ju8t1n203/Midi-Bass-Guitar/Spring25Docs/Project Prez.odp

## MIDI Bass Guitar

A Project Presented By: Owen Fujii


All images taken by Owen Fujii

## Project Goals

- Develop a MIDI controlled bass guitar
- Bass guitar will closely match the sound of a human player
- Project will have robust firmware to handle a variety of conditions

## Semester Goals

- Develop Firmware for Project
- Develop Schematic/PCB for Project
- Begin planning mechanical platform

## System Breakdown

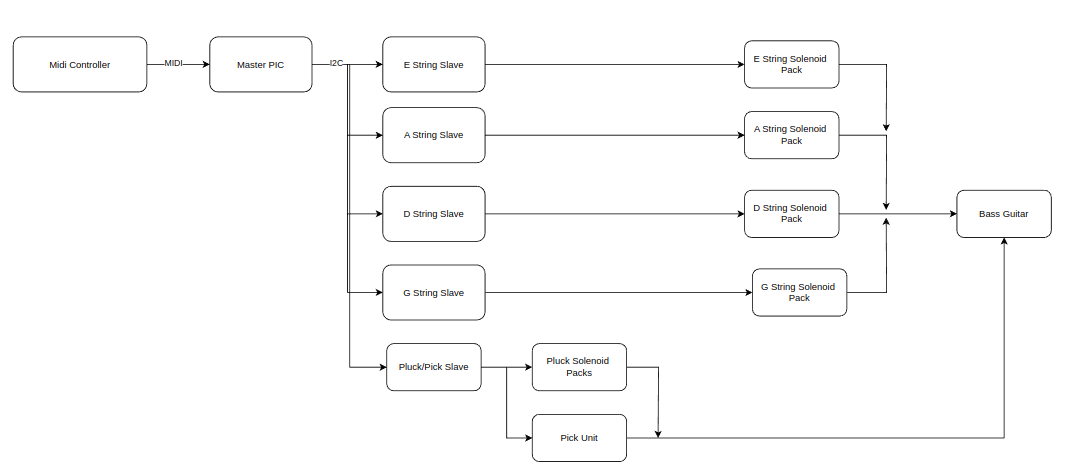
[picture p2: figure]

## Serial Structure

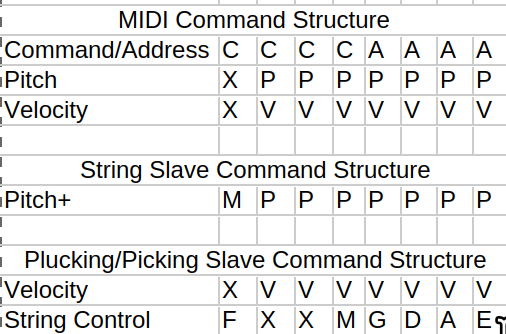
[picture p3: figure]

C = Command

A = Address

P = Pitch

V = Velocity

M = Mute

F = Pick

G = G String

D = D String

A = A String

E = E String

X = Not used

## MIDI

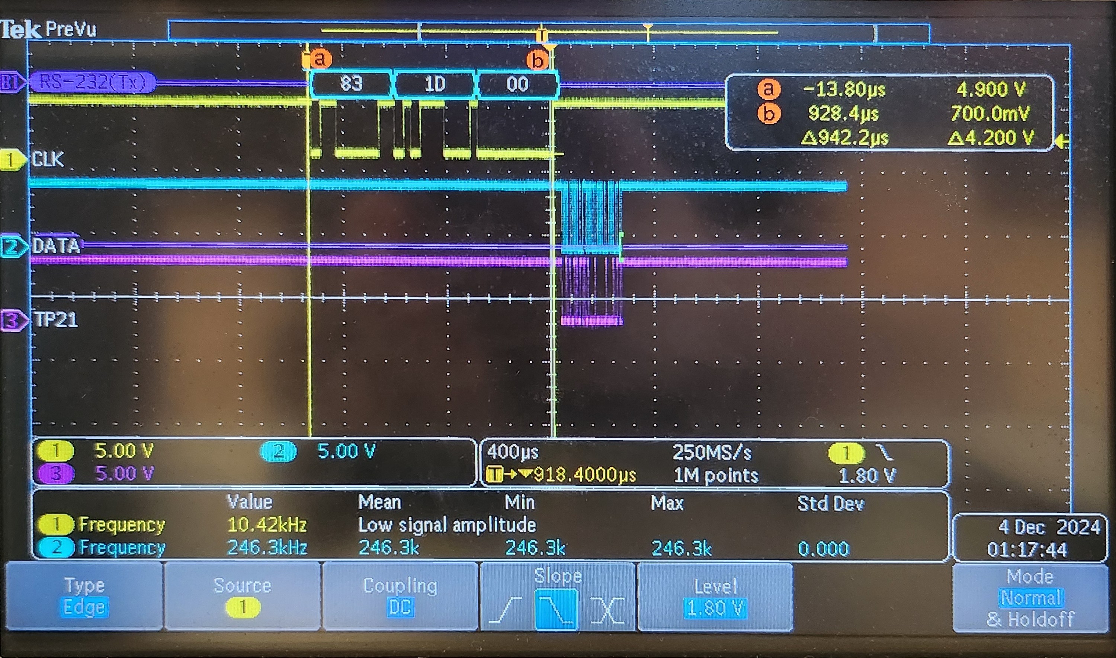
[picture p4: figure]

## I2C

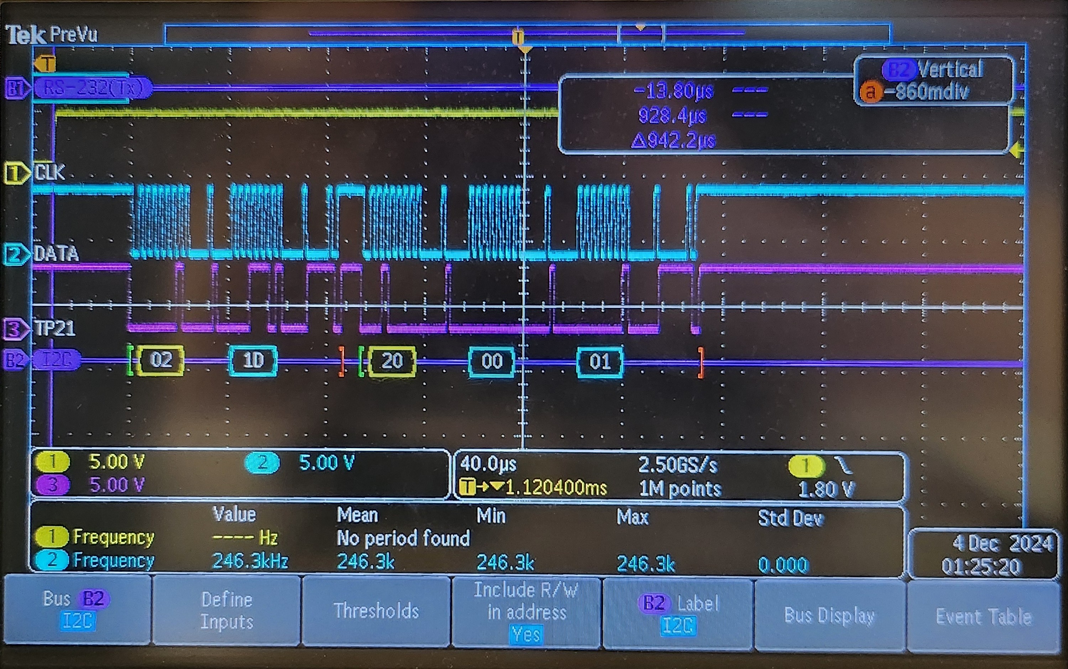
[picture p5: figure]

Notes: Mention why I2C is 400khz

  MIDI = 31.25kHz = 32uS per bit = 320uS per byte transmitted
  I2C = 400kHz = 2.5uS per bit = 25uS per byte transmitted
  120 Beats Per Minute (BPM)
  60s/120bpm = 500ms per beat
  Meaning 1/8th notes are 250ms

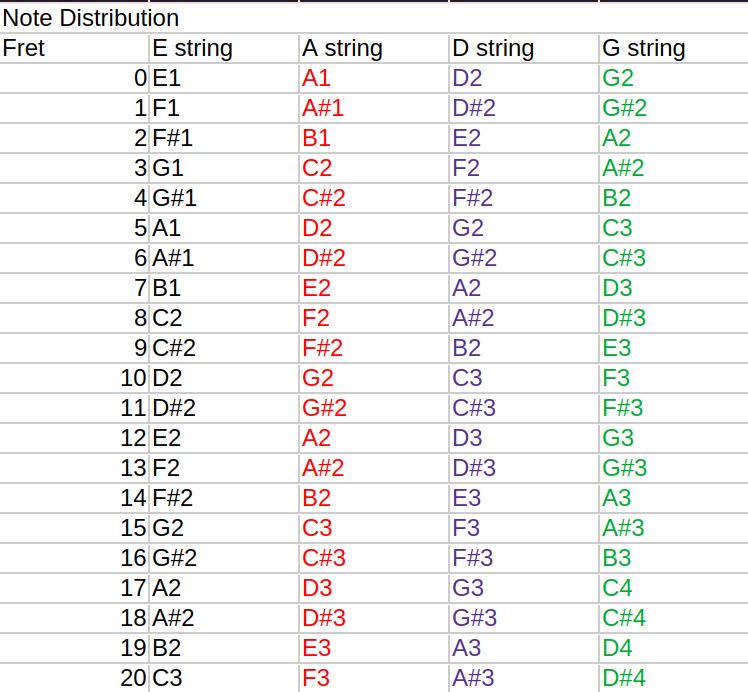
[picture p6: figure]

## String Select

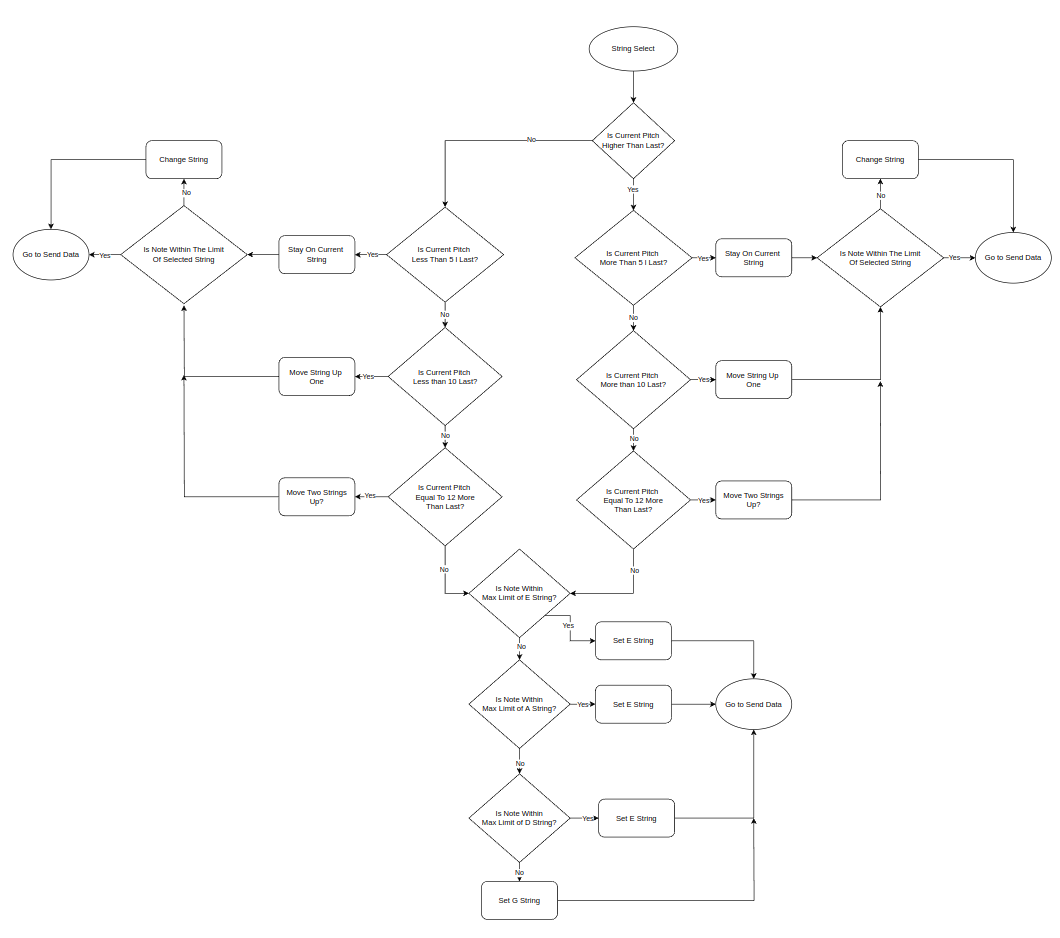
[picture p7: figure]

## External Control

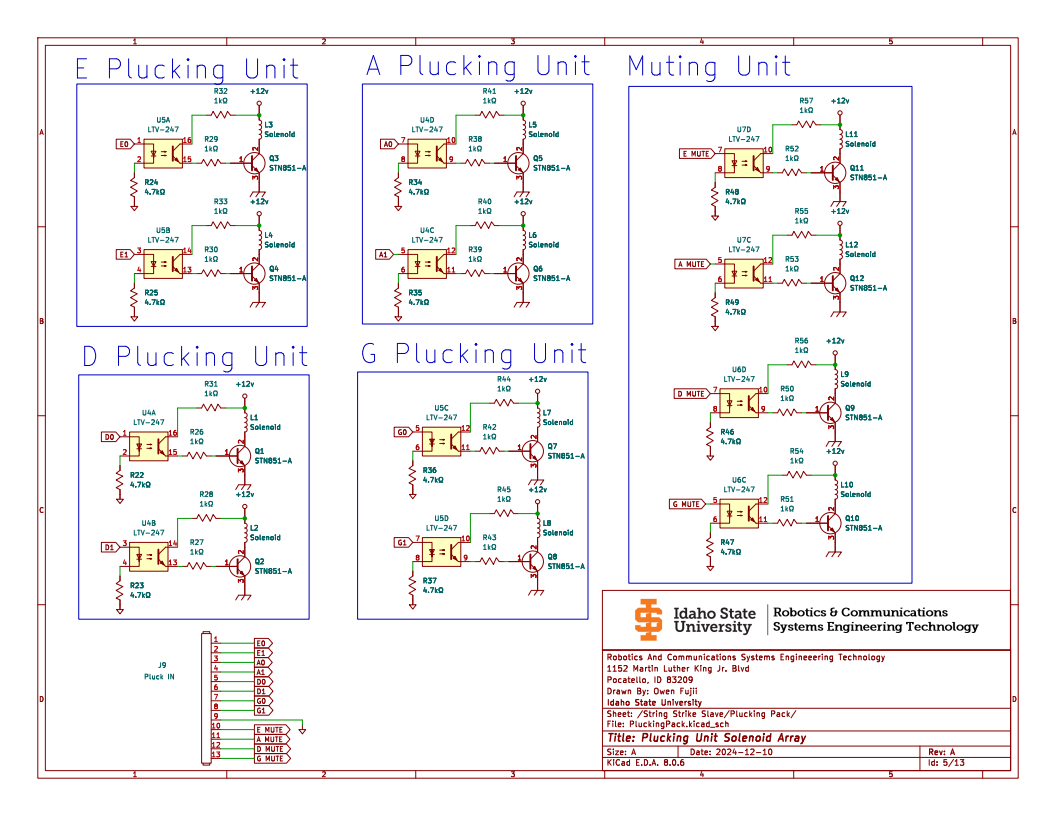
[picture p8: figure]
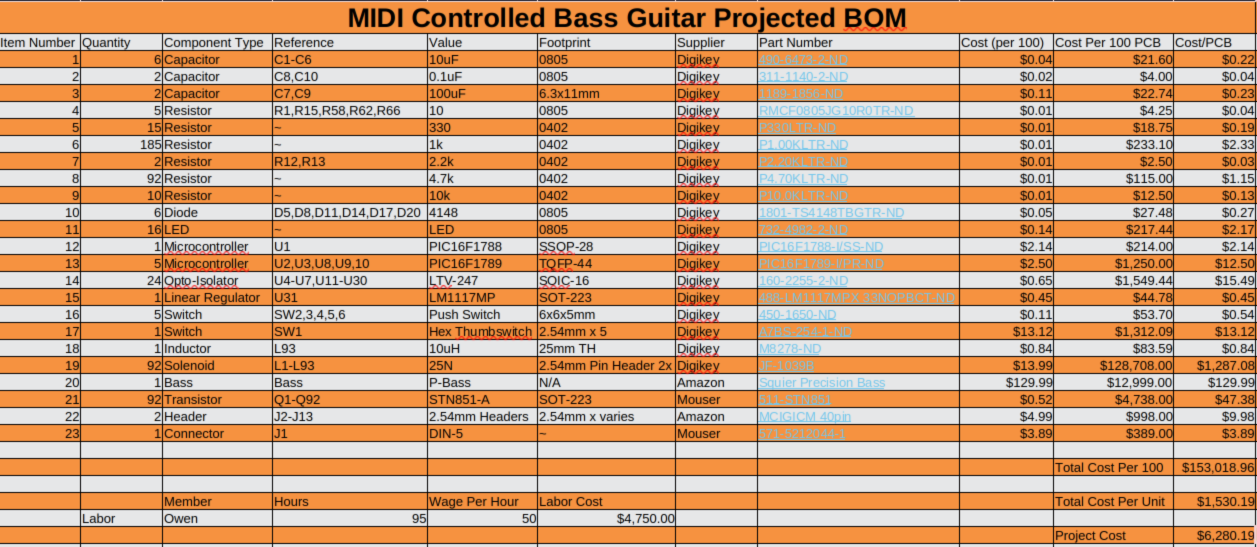
[picture p9: figure]

## Recommendations

- Finish developing string slave firmware
- Design PCB
- Design all mechanical interface hardware

## FIN

  Questions?

Check out the GitHub!!

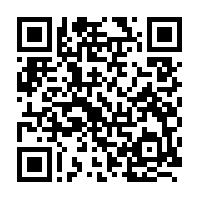
[picture p10: figure]
