ju8t1n203/Midi-Bass-Guitar/Spring25Docs/BOM.ods

MIDI Controlled Bass Guitar Projected BOM
Item Number | Quantity | Component Type | Reference | Value | Footprint | Supplier | Part Number | Cost (per 100) | Cost Per 100 PCB | Cost/PCB
1 | 3 | Capacitor | C1-C3 | 10uF | 0805 | Digikey | 490-6473-2-ND (https://www.digikey.com/en/products/detail/murata-electronics/GRM21BR61C106KE15K/2546903) | $0.04 | $10.80 | $0.11
2 | 2 | Capacitor | C5,C7 | 0.1uF | 0805 | Digikey | 311-1140-2-ND (https://www.digikey.com/en/products/detail/yageo/CC0805KRX7R9BB104/302874) | $0.02 | $4.00 | $0.04
3 | 2 | Capacitor | C4,C6 | 100uF | 6.3x11mm | Digikey | 1189-1856-ND (https://www.digikey.com/en/products/detail/rubycon/16YXF100MEFC6-3X11/3563101) | $0.11 | $22.74 | $0.23
4 | 3 | Resistor | R1,R15,R19 | 10 | 0805 | Digikey | RMCF0805JG10R0TR-ND | $0.01 | $2.55 | $0.03
5 | 9 | Resistor | ~ | 330 | 0402 | Digikey | P330LTR-ND (https://www.digikey.com/en/products/detail/panasonic-electronic-components/ERJ-2RKF3300X/1746189) | $0.01 | $11.25 | $0.11
6 | 21 | Resistor | ~ | 1k | 0402 | Digikey | P1.00KLTR-ND (https://www.digikey.com/en/products/detail/panasonic-electronic-components/ERJ-2RKF1001X/79729) | $0.01 | $26.46 | $0.26
7 | 20 | Power Resistor | ~ | 1K |  | Digikey | RA73F2A10KBTD | $1.06 | $2,120.00 | $21.20
8 | 2 | Resistor | R12,R13 | 2.2k | 0402 | Digikey | P2.20KLTR-ND (https://www.digikey.com/en/products/detail/panasonic-electronic-components/ERJ-2RKF2201X/1746150) | $0.01 | $2.50 | $0.03
9 | 23 | Diode | ~ | 4148 | 0805 | Digikey | 1801-TS4148TBGTR-ND (https://www.digikey.com/en/products/detail/taiwan-semiconductor-corporation/TS4148-RBG/15926409) | $0.05 | $105.34 | $1.05
10 | 30 | LED | ~ | LED | 0805 | Digikey | 732-4982-2-ND (https://www.digikey.com/en/products/detail/würth-elektronik/150080BS75000/4489912) | $0.14 | $407.70 | $4.08
11 | 1 | Microcontroller | U1 | PIC16F1788 | SSOP-28 | Digikey | PIC16F1788-I/SS-ND (https://www.digikey.com/en/products/detail/microchip-technology/PIC16F1788-I-SS/4080108) | $2.14 | $214.00 | $2.14
12 | 2 | Microcontroller | U2,U3,U8,U9,10 | PIC16F1789 | TQFP-44 | Digikey | PIC16F1789-I/PR-ND (https://www.digikey.com/en/products/detail/PIC16F1789-I/PT/PIC16F1789-I/PT-ND/4080209) | $2.50 | $500.00 | $5.00
13 | 5 | Opto-Isolator | U4-U7,U11-U30 | LTV-247 | SOIC-16 | Digikey | 160-2255-2-ND (https://www.digikey.com/en/products/detail/liteon/LTV-247/4307982?s=N4IgTCBcDaIDIBUBqBaMAWA7CAugXyA) | $0.65 | $322.80 | $3.23
14 | 1 | Linear Regulator | U31 | LM1117MP | SOT-223 | Digikey | 488-LM1117MPX 33NOPBCT-ND (https://www.digikey.com/en/products/detail/onsemi/LM1117MPX-33NOPB/13559871) | $0.45 | $44.78 | $0.45
15 | 3 | Switch | SW2-SW4 | Push Switch | 6x6x5mm | Digikey | 450-1650-ND (https://www.digikey.com/en/products/detail/te-connectivity-alcoswitch-switches/1825910-6/1632536) | $0.11 | $32.22 | $0.32
16 | 1 | Switch | SW1 | Hex Thumbswitch | 2.54mm x 5 | Digikey | A7BS-254-1-ND (https://www.digikey.com/en/products/detail/omron-electronics-inc-emc-div/A7BS-254-1/368277) | $13.12 | $1,312.09 | $13.12
17 | 1 | Inductor | L93 | 10uH | 25mm TH | Digikey | M8278-ND (https://www.digikey.com/en/products/detail/bourns-inc/5800-100-RC/774818) | $0.84 | $83.59 | $0.84
18 | 20 | Solenoid | L1-L93 | 25N | 2.54mm Pin Header 2x | Digikey | JF-1039B (https://www.amazon.com/gp/product/B07Z4JQPBN/ref=ppx_yo_dt_b_search_asin_title?ie=UTF8) | $13.99 | $27,980.00 | $279.80
19 | 1 | Bass | Bass | P-Bass | N/A | Amazon | Squier Precision Bass (https://www.amazon.com/Fender-Precision-Beginner-Warranty-Lessons/dp/B0CSLMDCLY/ref=sr_1_5?sr=8-5) | $129.99 | $12,999.00 | $129.99
20 | 10 | Transistor | Q1-Q50 | STN851-A | SOT-223 | Mouser | 511-STN851 (https://www.mouser.com/ProductDetail/STMicroelectronics/STN851?qs=at/PaO0D8JbvrofIPM%2BQzQ%3D%3D) | $0.52 | $515.00 | $5.15
21 | 2 | Header | J2-J13 | 2.54mm Headers | 2.54mm x varies | Amazon | MCIGICM 40pin (https://www.amazon.com/MCIGICM-Header-2-45mm-Arduino-Connector/dp/B07PKKY8BX) | $4.99 | $998.00 | $9.98
22 | 1 | Connector | J1 | DIN-5 | ~ | Mouser | 571-5212044-1 (https://www.mouser.com/ProductDetail/TE-Connectivity/5212044-1?qs=Dic%252B%252BaXKxRiey0gRD2%2Fghg%3D%3D) | $3.89 | $389.00 | $3.89
23 | 1 | PETG | ~ | 1Kg | ~ | Amazon | 1.75mm Matte Grey PETG | $13.99 | $1,399.00 | $13.99
24 | 3 | Aluminuim | ~ | 3m | ~ | Amazon | 1220mm 2020 Aluminuim Extrusion | $35.25 | $10,575.00 | $105.75
25 | 1 | Weather Stripping | ~ | 2ft | ~ | Amazon | Weather Strip Silicone D Shaped | $0.99 | $99.00 | $0.99
 |  |  |  |  |  |  |  |  | Total Cost Per 100 | $60,176.82
 |  | Member | Hours | Wage Per Hour | Labor Cost
 |  |  |  |  |  |  |  |  | Total Cost Per Unit | $601.77
 | Labor | Owen | 95 | 50 | $4,750.00
 |  | Justin | 96 | 50 | $4,800.00 |  |  |  | Project Cost | $10,151.77
