ju8t1n203/Midi-Bass-Guitar/JustinHours.xlsx

Sheet: W1
Justin Week One Hours
Date | Clock-In | Clock-Out | Time(hrs) | Description
2025-04-07 | 10:00:00 | 11:00:00 | 1 | breadboarding
2025-04-07 | 13:15:00 | 14:30:00 | 1.25 | git branch organization
2025-04-08 | 13:00:00 | 14:30:00 | 1.5 | finished breadboarding
2025-04-09 | 10:00:00 | 12:00:00 | 2 | figuring out midi
2025-04-09 | 13:15:00 | 15:00:00 | 1.75 | I2C troubleshooting
2025-04-10 | 10:00:00 | 11:00:00 | 1 | I2C troubleshooting
2025-04-10 | 13:15:00 | 14:30:00 | 1.25 | I2C troubleshooting
2025-04-11 | 13:00:00 | 14:30:00 | 1.5 | I2C troubleshooting
2025-04-11 | 10:00:00 | 12:00:00 | 2 | I2C troubleshooting
2025-04-12 | 13:15:00 | 15:00:00 | 1.75 | I2C troubleshooting
2025-04-12 | 10:00:00 | 11:00:00 | 1 | I2C troubleshooting
2025-04-13 | 13:15:00 | 14:30:00 | 1.25 | I2C troubleshooting
2025-04-13 | 13:00:00 | 14:30:00 | 1.5 | I2C troubleshooting
 |  | Total: | 18.75

Sheet: W2
Justin Week Two Hours
Date | Clock-In | Clock-Out | Time(hrs) | Description
2025-04-14 | 9:00:00 | 11:40:00 | 2.667 | I2C troubleshooting
2025-04-14 | 12:40:00 | 14:30:00 | 1.833 | I2C troubleshooting
2025-04-15 | 9:00:00 | 11:45:00 | 2.75 | I2C troubleshooting
2025-04-15 | 13:15:00 | 14:40:00 | 1.417 | I2C troubleshooting
2025-04-16 | 9:00:00 | 11:40:00 | 2.667 | Finalizing Fret Slave
2025-04-16 | 13:00:00 | 16:00:00 | 3 | Finalizing Fret Slave
2025-04-17 | 9:15:00 | 11:40:00 | 2.417 | Investigationg MIDI over IR
2025-04-17 | 13:00:00 | 15:30:00 | 2.5 | Investigationg MIDI over IR
2025-04-18 | 9:00:00 | 11:40:00 | 2.667 | Investigationg MIDI over IR
2025-04-18 | 13:00:00 | 15:00:00 | 2 | Investigationg MIDI over IR
 |  | Total: | 23.917

Sheet: W3
Justin Week Three Hours
Date | Clock-In | Clock-Out | Time(hrs) | Description
2025-04-21 | 9:00:00 | 11:40:00 | 2.667 | Investigationg MIDI over IR
2025-04-21 | 12:40:00 | 14:30:00 | 1.833 | Investigationg MIDI over IR
2025-04-22 | 9:00:00 | 11:45:00 | 2.75 | Investigationg MIDI over IR
2025-04-22 | 13:15:00 | 14:40:00 | 1.417 | Investigationg MIDI over IR
2025-04-23 | 9:00:00 | 11:40:00 | 2.667 | Investigationg MIDI over IR
2025-04-23 | 13:00:00 | 16:00:00 | 3 | Investigationg MIDI over IR
2025-04-24 | 9:15:00 | 11:40:00 | 2.417 | Investigationg MIDI over IR
2025-04-24 | 13:00:00 | 15:30:00 | 2.5 | Investigationg MIDI over IR
2025-04-25 | 9:00:00 | 11:40:00 | 2.667 | Investigationg MIDI over IR
2025-04-25 | 13:00:00 | 15:00:00 | 2 | Investigationg MIDI over IR
 |  | Total: | 23.917

Sheet: W4
Justin Week Four Hours
Date | Clock-In | Clock-Out | Time(hrs) | Description
2025-04-28 | 9:30:00 | 11:40:00 | 2.167 | Investigationg MIDI over IR
2025-04-28 | 13:00:00 | 14:40:00 | 1.667 | Investigationg MIDI over IR
2025-04-29 | 9:00:00 | 11:40:00 | 2.667 | Investigationg MIDI over IR
2025-04-29 | 12:45:00 | 14:40:00 | 1.917 | Investigationg MIDI over IR
2025-04-30 | 9:15:00 | 11:40:00 | 2.417 | Investigationg MIDI over IR
2025-04-30 | 12:30:00 | 16:00:00 | 3.5 | Write up for MIDI over IR
2025-05-01 | 9:15:00 | 11:20:00 | 2.083 | Write up for MIDI over IR
2025-05-01 | 13:00:00 | 15:00:00 | 2 | Write up for fret slave
2025-05-02 | 9:10:00 | 11:40:00 | 2.5 | Write up for MIDI over IR
2025-05-02 | 13:00:00 | 15:00:00 | 2 | Write up for fret slave
 |  | Total: | 22.917

Sheet: W5
Justin Week Five Hours
Date | Clock-In | Clock-Out | Time(hrs) | Description
2025-05-05 | 9:30:00 | 11:40:00 | 2.167 | Write up for MIDI over IR
2025-05-05 | 13:00:00 | 14:40:00 | 1.667 | Soldering Amplifier Board
2025-05-06 | 9:00:00 | 11:40:00 | 2.667 | Writing Presentation
2025-05-06 |  |  | 0.000
2025-05-07 |  |  | 0.000
2025-05-07 |  |  | 0
2025-05-08 |  |  | 0.000
2025-05-08 |  |  | 0
 |  | Total: | 6.500

Sheet: Sem6
Week# | Date | In | Out | Time | Description
1 | 2025-10-20 | 11:00:00 | 12:00:00 | 1 | IR Tx Board Design
1 | 2025-10-20 | 12:30:00 | 14:50:00 | 2.333 | IR Tx Board Design | Part | Link
1 | 2025-10-21 | 11:00:00 | 11:33:00 | 0.550 | IR Tx Board Design | 2Ω Power Resistor | https://www.mouser.com/ProductDetail/Bourns/PWR220T-20-2R00F?qs=sGAEpiMZZMtlubZbdhIBIIFas8kKGM5fidmq4iLVFG8%3D
1 | 2025-10-21 | 13:00:00 | 16:30:00 | 3.500 | IR Tx Board Design
1 | 2025-10-22 | 11:00:00 | 12:00:00 | 1.000 | IR Rx Circuit Design | 8Pin Molex | 430450810
1 | 2025-10-22 | 13:00:00 | 14:50:00 | 1.833 | IR Rx Circuit Design | 2Pin Molex | 430450200
1 | 2025-10-23 | 13:00:00 | 15:00:00 | 2.000 | IR Tx Board Design
1 | 2025-10-24 | 10:00:00 | 12:00:00 | 2.000 | IR Tx Board Design
2 | 2025-10-27 | 11:00:00 | 12:00:00 | 1.000 | IR Rx Circuit Design
2 | 2025-10-27 | 13:00:00 | 14:30:00 | 1.500 | IR Rx Circuit Design
2 | 2025-10-28 | 10:30:00 | 12:00:00 | 1.500 | IR Rx Circuit Design
2 | 2025-10-28 | 12:30:00 | 14:30:00 | 2.000 | IR Rx Circuit Design
2 | 2025-10-29 | 13:00:00 | 15:00:00 | 2.000 | IR Tx Board Design
2 | 2025-10-29 | 10:00:00 | 12:00:00 | 2.000 | IR Tx Board Design
2 | 2025-10-30 | 11:00:00 | 12:00:00 | 1.000 | IR Rx Circuit Design
2 | 2025-10-30 | 13:00:00 | 14:30:00 | 1.500 | IR Rx Circuit Design
2 | 2025-10-31 | 10:30:00 | 12:00:00 | 1.500 | IR Rx Circuit Design
2 | 2025-10-31 | 12:30:00 | 14:30:00 | 2.000 | IR Rx Circuit Design
3 | 2025-11-03 | 11:00:00 | 12:00:00 | 1.000 | IR Tx Board Design
3 | 2025-11-03 | 12:50:00 | 15:10:00 | 2.333 | IR Tx Board Design
3 | 2025-11-04 | 11:00:00 | 12:05:00 | 1.083 | IR Tx Board Design
3 | 2025-11-04 | 13:00:00 | 14:35:00 | 1.583 | IR Tx Board Design
3 | 2025-11-05 | 9:00:00 | 9:40:00 | 0.667 | IR Rx Circuit Design
3 | 2025-11-05 | 9:40:00 | 12:00:00 | 2.333 | Bass Fret Bar Design
3 | 2025-11-05 | 13:00:00 | 16:00:00 | 3.000 | Equipment Maintenance
3 | 2025-11-06 | 13:30:00 | 15:30:00 | 2.000 | Equipment Maintenance
3 | 2025-11-07 | 9:00:00 | 12:00:00 | 3.000 | Equipment Maintenance
3 | 2025-11-07 | 13:00:00 | 15:00:00 | 2.000 | Equipment Maintenance
4 | 2025-11-10 | 11:00:00 | 12:00:00 | 1.000 | Equipment Maintenance
4 | 2025-11-10 | 13:00:00 | 15:00:00 | 2.000 | Administration
4 | 2025-11-11 | 11:00:00 | 12:00:00 | 1.000 | CAD work
4 | 2025-11-11 | 13:00:00 | 15:00:00 | 2.000 | Designing SUDO code
4 | 2025-11-12 | 11:06:00 | 12:15:00 | 1.150 | CAD work
4 | 2025-11-12 | 13:00:00 | 14:50:00 | 1.833 | Universal Master circuit design
4 | 2025-11-13 | 10:50:00 | 11:30:00 | 0.667 | Universal Master circuit design
4 | 2025-11-13 | 11:30:00 | 12:00:00 | 0.500 | Fret circuit design
4 | 2025-11-13 | 13:00:00 | 13:30:00 | 0.500 | Universal Master circuit design
4 | 2025-11-13 | 13:30:00 | 14:30:00 | 1.000 | Fret circuit design
4 | 2025-11-13 | 14:30:00 | 15:00:00 | 0.500 | Pluck circuit design
4 | 2025-11-14 | 9:00:00 | 12:30:00 | 3.500 | Universal Master PCB design
4 | 2025-11-14 | 13:00:00 | 14:30:00 | 1.500 | Universal Master PCB design
4 | 2025-11-15 | 11:00:00 | 14:00:00 | 3.000 | Universal Slave PCB design
