ju8t1n203/Midi-Bass-Guitar/Bass Guitar Cad Models/F25/Fret/GenrealBar.stl

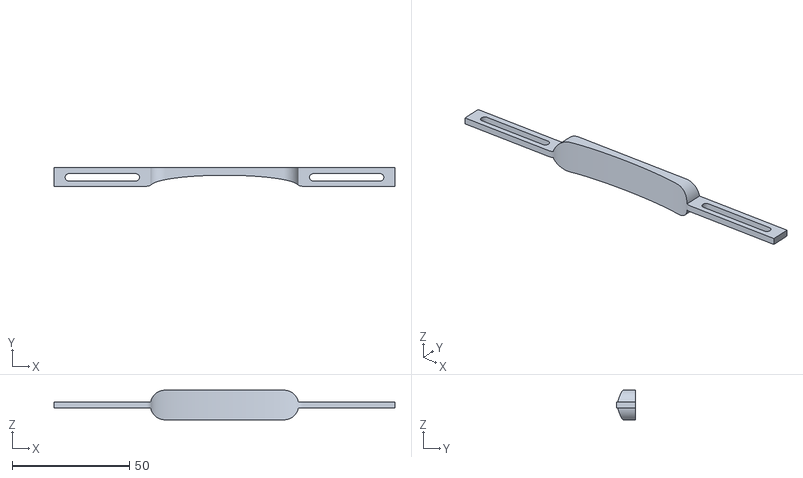
[picture p60: CAD file, 2025-11-12]
Bass Guitar Cad Models/F25/Fret/GenrealBar.stl
145.7 x 7.92 x 12.7
