ju8t1n203/Midi-Bass-Guitar/Bass Guitar Cad Models/S25/4n Solenoid Pin.SLDPRT

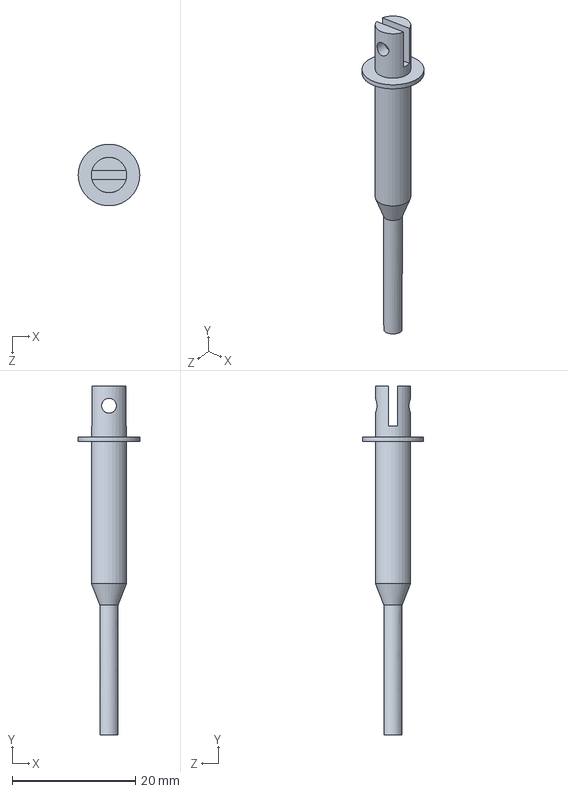
[picture p61: CAD file, 2025-11-05]
Bass Guitar Cad Models/S25/4n Solenoid Pin.SLDPRT
10.0 x 56.6 x 9.97 mm
