ju8t1n203/Midi-Bass-Guitar/Bass Guitar Cad Models/S25/Electronics/DIN Mounting Rail.SLDPRT

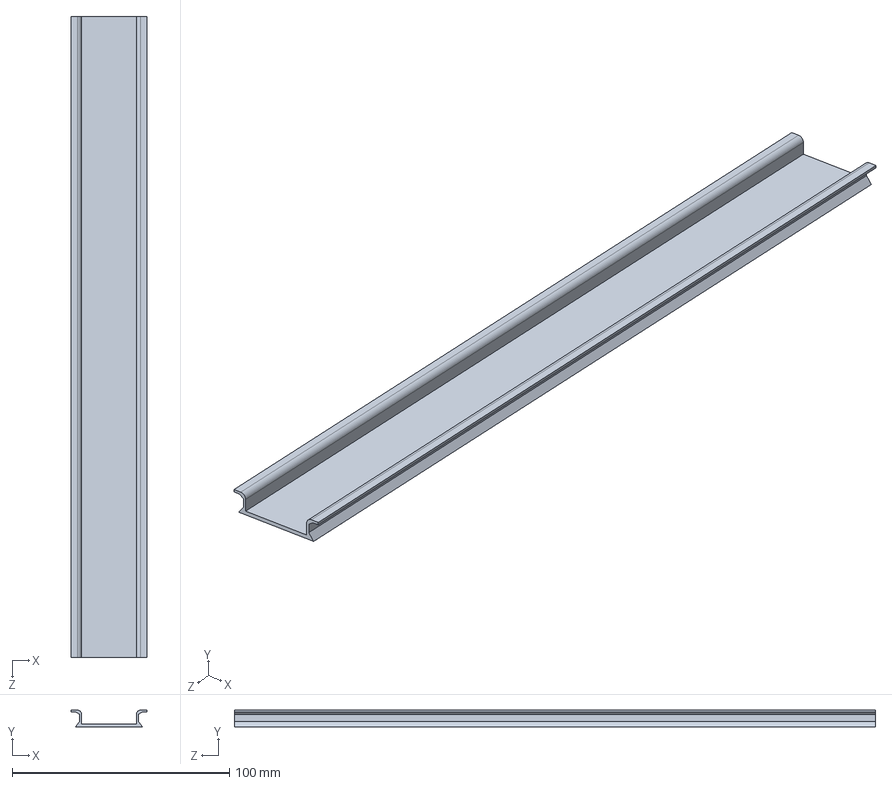
[picture p62: CAD file, 2025-11-05]
Bass Guitar Cad Models/S25/Electronics/DIN Mounting Rail.SLDPRT
34.8 x 7.82 x 295.0 mm
