ju8t1n203/Midi-Bass-Guitar/Bass Guitar Cad Models/S25/Fret Bars/2nd Fret Bar.SLDPRT

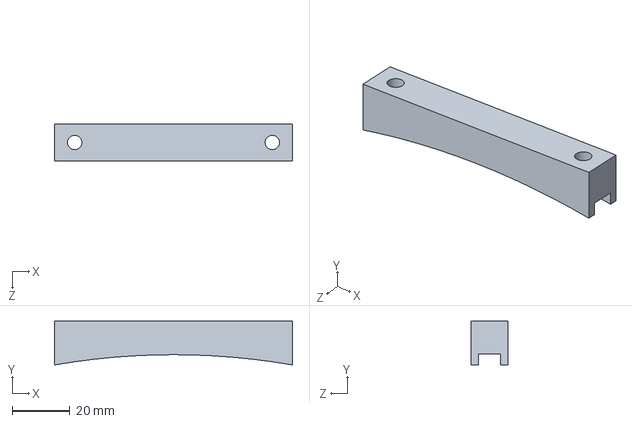
[picture p63: CAD file, 2025-11-05]
Bass Guitar Cad Models/S25/Fret Bars/2nd Fret Bar.SLDPRT
82.6 x 15.2 x 12.7 mm
