ju8t1n203/Midi-Bass-Guitar/Bass Guitar Cad Models/S25/STLs/5th Fret Bar.STL

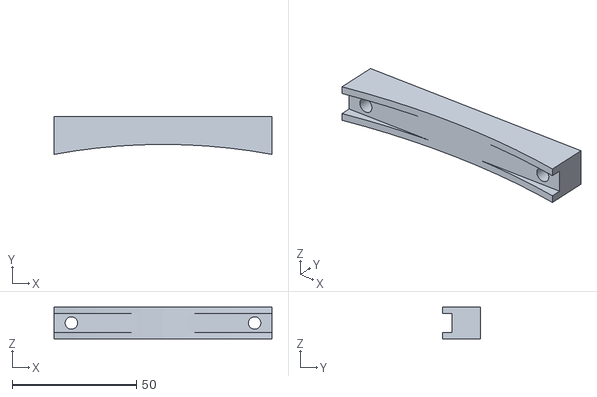
[picture p64: CAD file, 2025-11-05]
Bass Guitar Cad Models/S25/STLs/5th Fret Bar.STL
87.8 x 15.2 x 12.7
