ju8t1n203/Midi-Bass-Guitar/Bass Guitar Cad Models/F25/Fret/SolenoidMount.stl

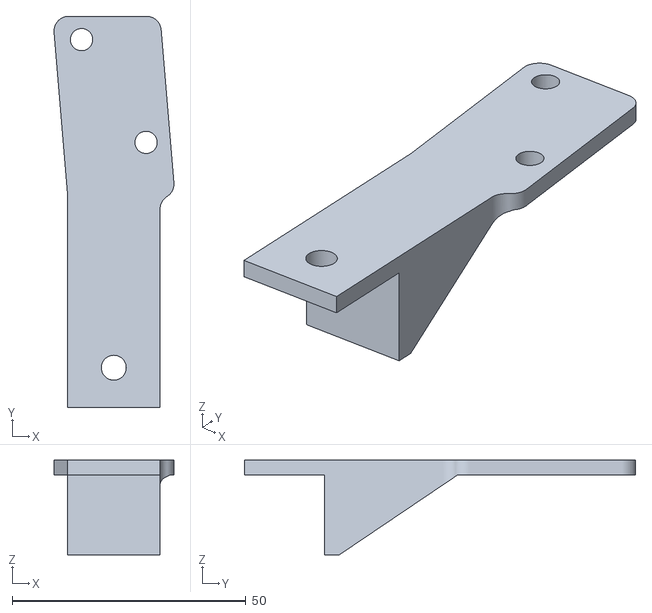
[picture p65: CAD file, 2025-11-11]
Bass Guitar Cad Models/F25/Fret/SolenoidMount.stl
25.7 x 83.8 x 20.3
