ju8t1n203/Midi-Bass-Guitar/Bass Guitar Cad Models/S25/Electronics/2.54mm Header Single.SLDPRT

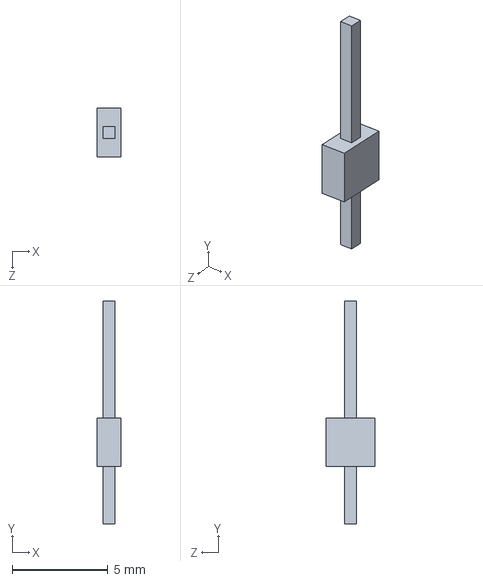
[picture p66: CAD file, 2025-11-05]
Bass Guitar Cad Models/S25/Electronics/2.54mm Header Single.SLDPRT
1.27 x 11.6 x 2.54 mm
