ju8t1n203/Midi-Bass-Guitar/Bass Guitar Cad Models/S25/Fret Bars/14th Fret Bar.SLDPRT

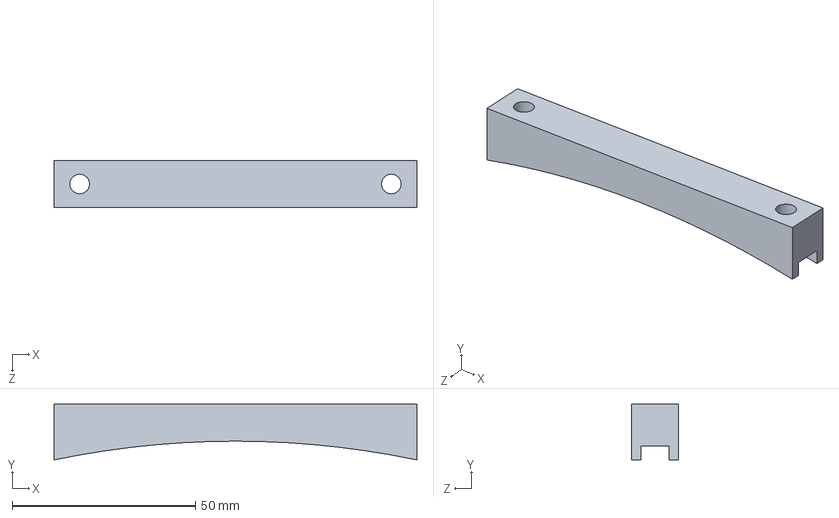
[picture p67: CAD file, 2025-11-05]
Bass Guitar Cad Models/S25/Fret Bars/14th Fret Bar.SLDPRT
98.9 x 15.2 x 12.7 mm
