ju8t1n203/Midi-Bass-Guitar/Bass Guitar Cad Models/S25/Small Mounting Bracket.SLDPRT

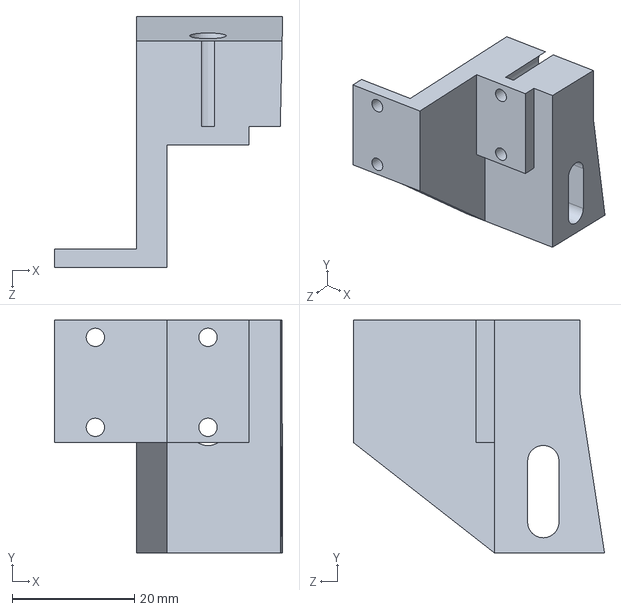
[picture p68: CAD file, 2025-11-05]
Bass Guitar Cad Models/S25/Small Mounting Bracket.SLDPRT
37.3 x 38.0 x 41.0 mm
