ju8t1n203/Midi-Bass-Guitar/Bass Guitar Cad Models/S25/STLs/20th Fret Bar.STL

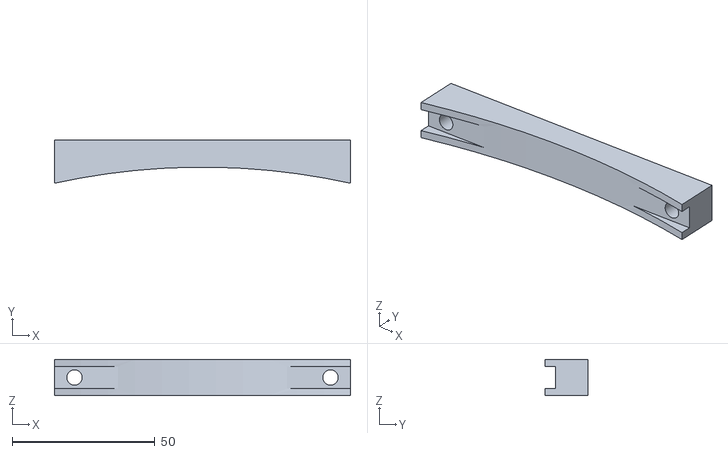
[picture p69: CAD file, 2025-11-05]
Bass Guitar Cad Models/S25/STLs/20th Fret Bar.STL
103.7 x 15.2 x 12.7
