ju8t1n203/Midi-Bass-Guitar/Bass Guitar Cad Models/S25/Electronics/2.54mm Header 21-pin.SLDPRT

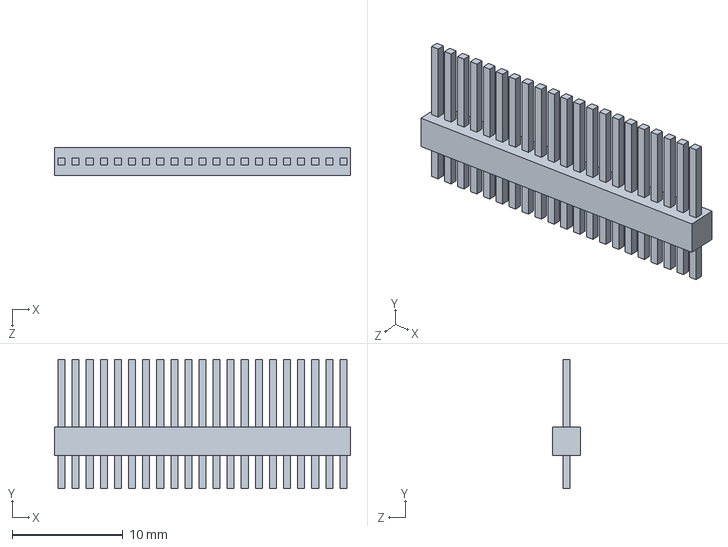
[picture p70: CAD file, 2025-11-05]
Bass Guitar Cad Models/S25/Electronics/2.54mm Header 21-pin.SLDPRT
26.7 x 11.6 x 2.54 mm
