ju8t1n203/Midi-Bass-Guitar/Bass Guitar Cad Models/S25/Fret Bars/5th Fret Bar.SLDPRT

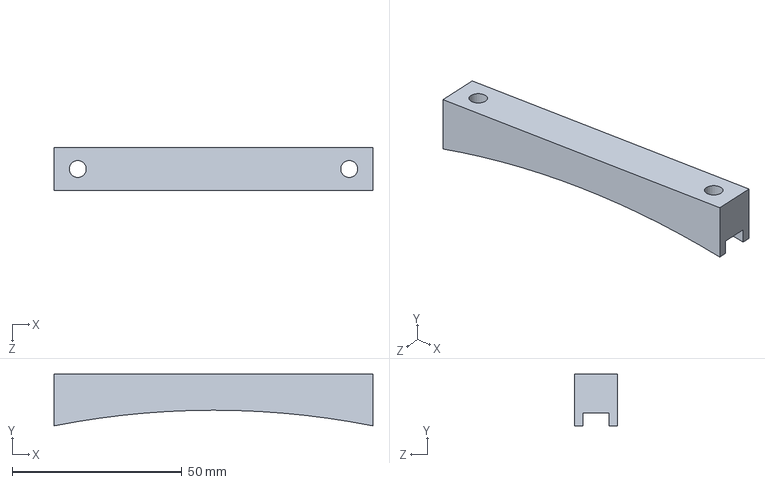
[picture p71: CAD file, 2025-11-05]
Bass Guitar Cad Models/S25/Fret Bars/5th Fret Bar.SLDPRT
93.9 x 15.2 x 12.7 mm
