ju8t1n203/Midi-Bass-Guitar/Bass Guitar Cad Models/S25/P-Bass Body.SLDPRT

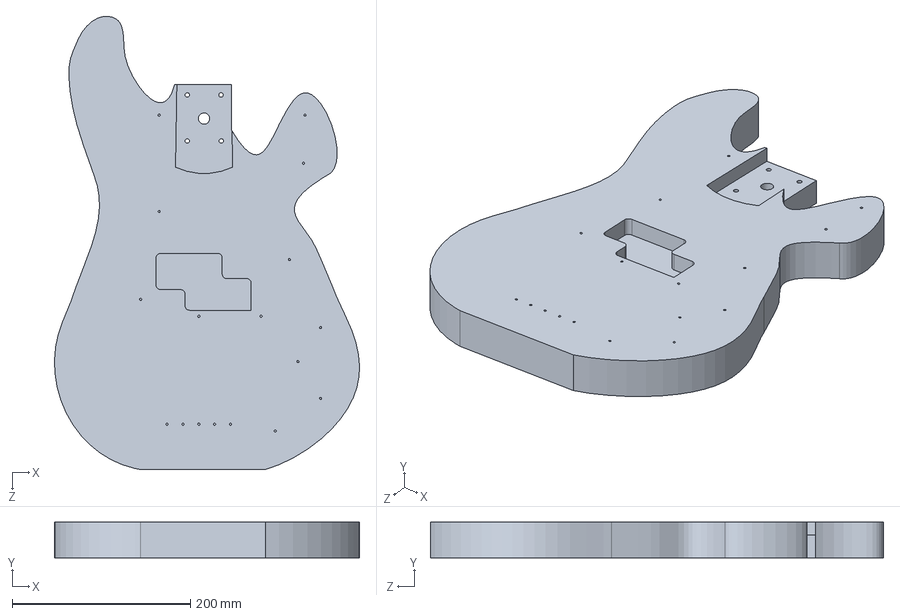
[picture p72: CAD file, 2025-11-05]
Bass Guitar Cad Models/S25/P-Bass Body.SLDPRT
341.8 x 40.0 x 507.9 mm
