ju8t1n203/Midi-Bass-Guitar/Bass Guitar Cad Models/S25/Electronics/Solenoid Hori Mount.SLDPRT

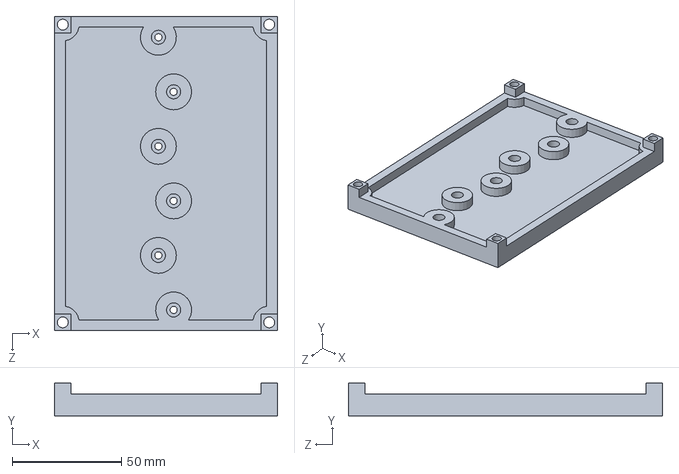
[picture p74: CAD file, 2025-11-05]
Bass Guitar Cad Models/S25/Electronics/Solenoid Hori Mount.SLDPRT
102.2 x 15.0 x 144.1 mm
