ju8t1n203/Midi-Bass-Guitar/Bass Guitar Cad Models/S25/Fret Bars/Sponge Blank.SLDPRT

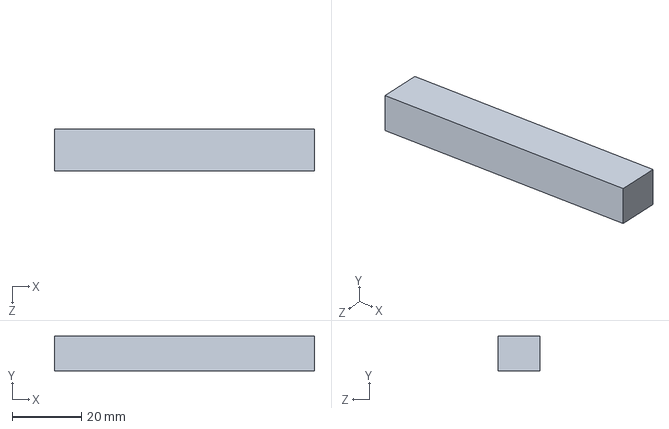
[picture p75: CAD file, 2025-11-05]
Bass Guitar Cad Models/S25/Fret Bars/Sponge Blank.SLDPRT
74.8 x 10.0 x 12.0 mm
