ju8t1n203/Midi-Bass-Guitar/Bass Guitar Cad Models/S25/Top Cross Support.SLDPRT

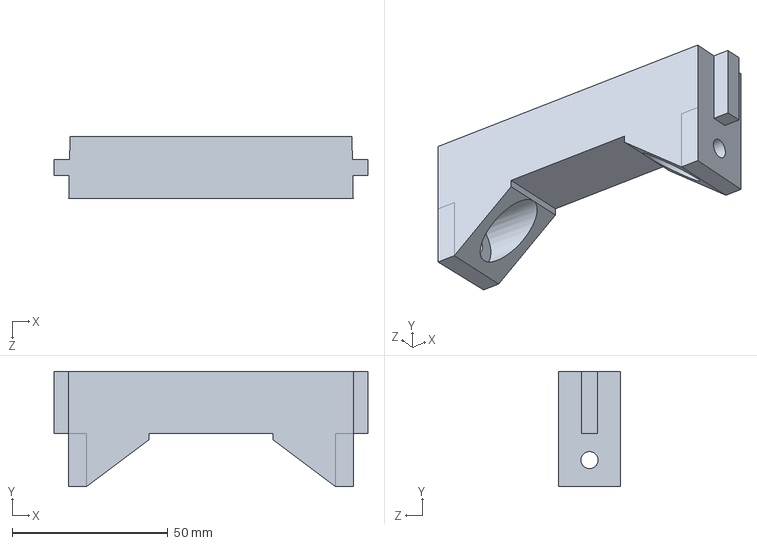
[picture p77: CAD file, 2025-11-05]
Bass Guitar Cad Models/S25/Top Cross Support.SLDPRT
100.9 x 37.0 x 20.0 mm
