ju8t1n203/Midi-Bass-Guitar/Bass Guitar Cad Models/S25/2020 Extrusion Short.SLDPRT

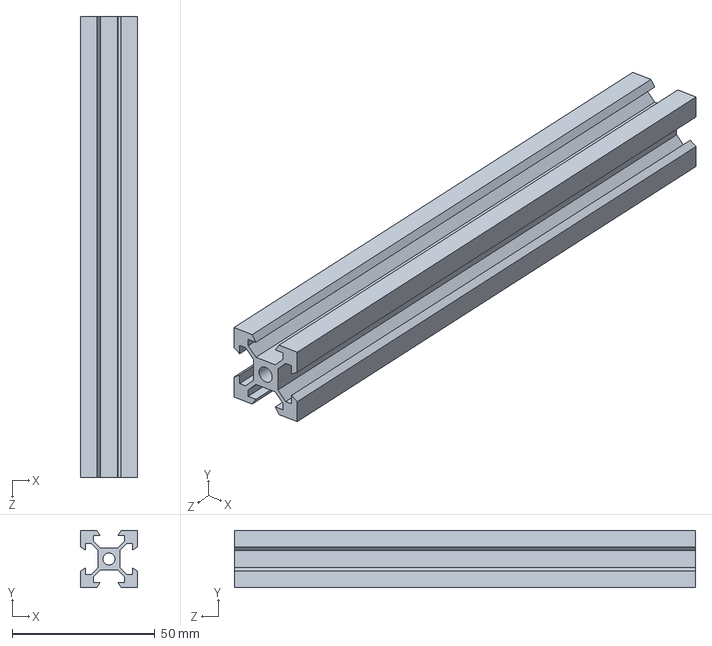
[picture p78: CAD file, 2025-11-05]
Bass Guitar Cad Models/S25/2020 Extrusion Short.SLDPRT
20.0 x 20.0 x 161.5 mm
