ju8t1n203/Midi-Bass-Guitar/Bass Guitar Cad Models/S25/Electronics/DIN Rail Mounts.SLDPRT

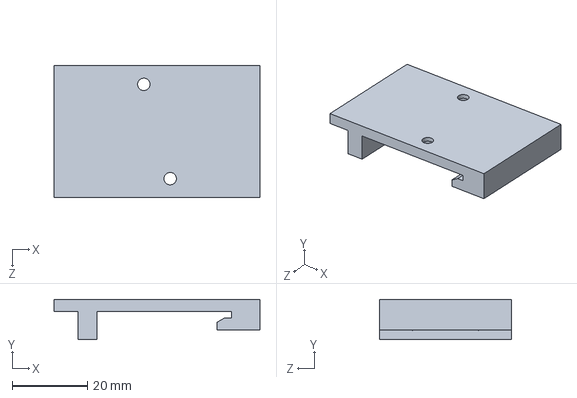
[picture p79: CAD file, 2025-11-05]
Bass Guitar Cad Models/S25/Electronics/DIN Rail Mounts.SLDPRT
54.6 x 10.7 x 35.0 mm
