ju8t1n203/Midi-Bass-Guitar/Bass Guitar Cad Models/S25/Fret Bars/3rd Fret Bar.SLDPRT

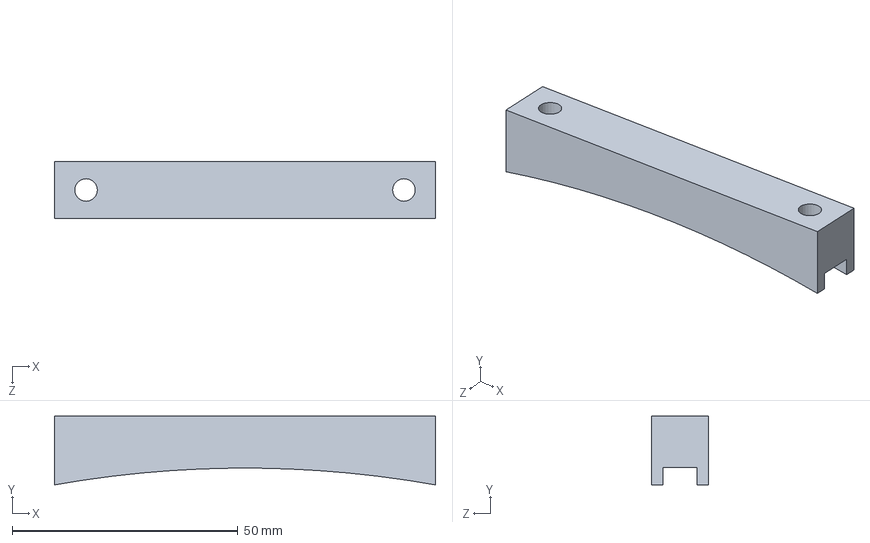
[picture p80: CAD file, 2025-11-05]
Bass Guitar Cad Models/S25/Fret Bars/3rd Fret Bar.SLDPRT
84.4 x 15.2 x 12.7 mm
