ju8t1n203/Midi-Bass-Guitar/Bass Guitar Cad Models/S25/Electronics/2.54mm Right Header 21-pin 2x.SLDPRT

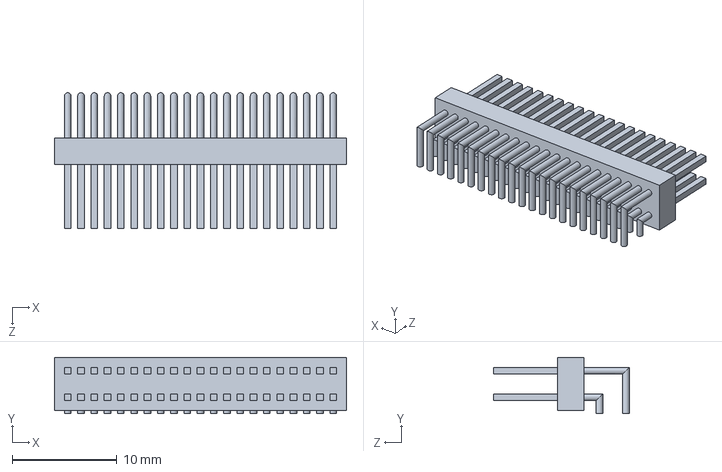
[picture p82: CAD file, 2025-11-05]
Bass Guitar Cad Models/S25/Electronics/2.54mm Right Header 21-pin 2x.SLDPRT
27.9 x 5.38 x 13.0 mm
