ju8t1n203/Midi-Bass-Guitar/Bass Guitar Cad Models/S25/Fret Bars/16th Fret Bar.SLDPRT

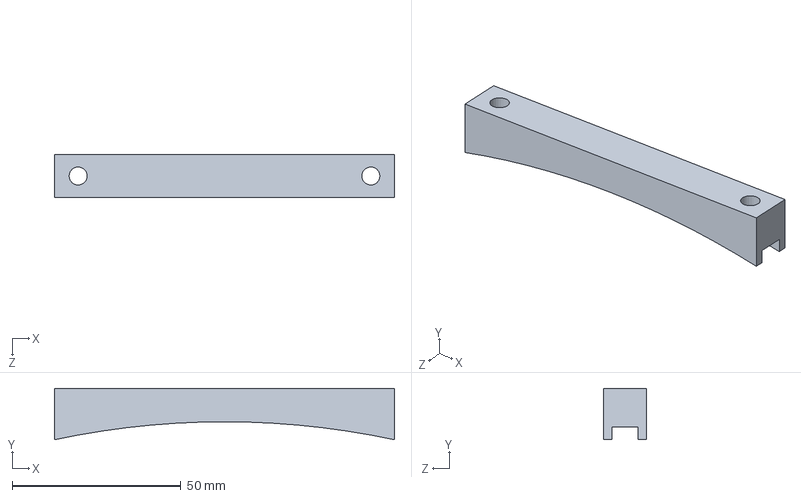
[picture p83: CAD file, 2025-11-05]
Bass Guitar Cad Models/S25/Fret Bars/16th Fret Bar.SLDPRT
100.7 x 15.2 x 12.7 mm
