ju8t1n203/Midi-Bass-Guitar/Bass Guitar Cad Models/S25/Muting Finger.SLDPRT

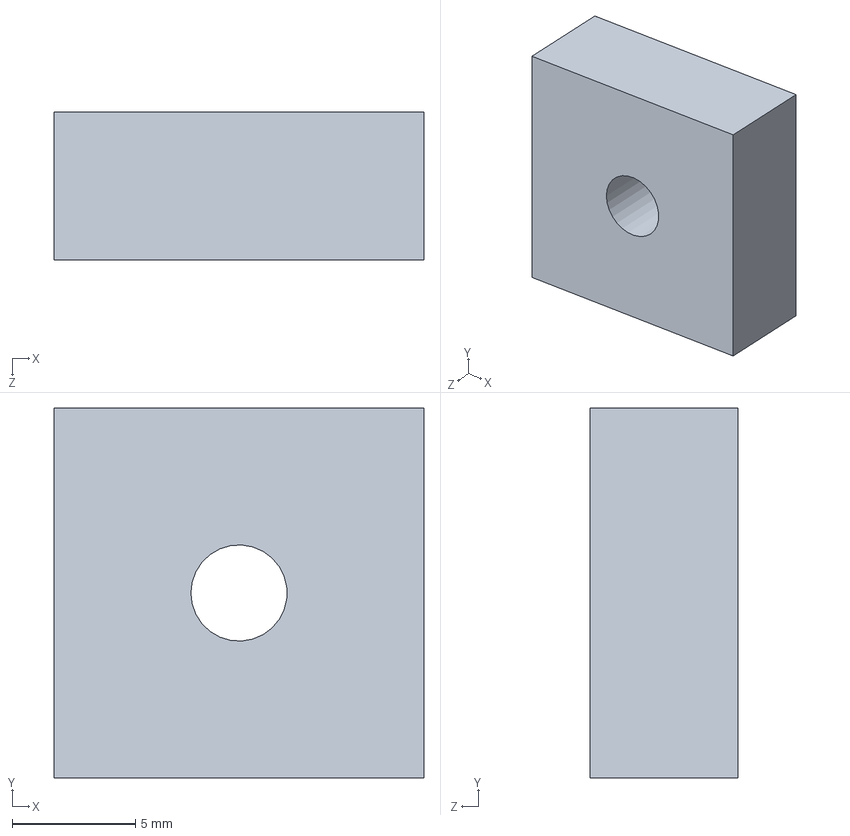
[picture p84: CAD file, 2025-11-05]
Bass Guitar Cad Models/S25/Muting Finger.SLDPRT
15.0 x 15.0 x 6.00 mm
