ju8t1n203/Midi-Bass-Guitar/Bass Guitar Cad Models/S25/Muting Bracket.SLDPRT

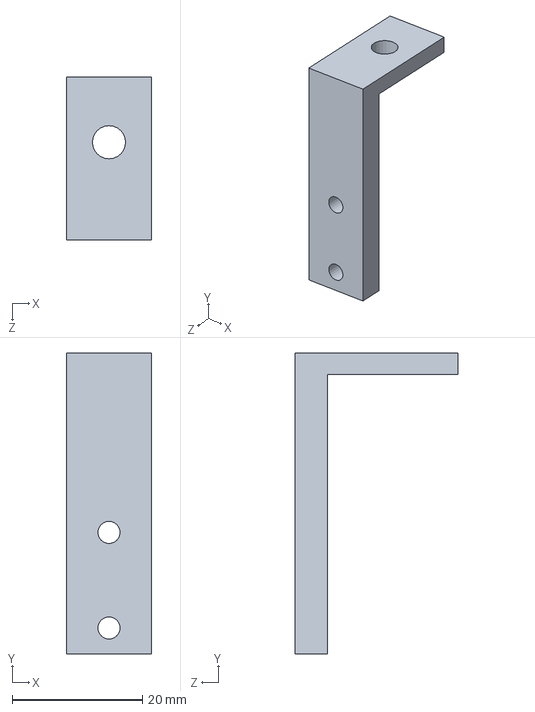
[picture p86: CAD file, 2025-11-05]
Bass Guitar Cad Models/S25/Muting Bracket.SLDPRT
13.0 x 46.3 x 25.0 mm
