ju8t1n203/Midi-Bass-Guitar/Bass Guitar Cad Models/S25/Electronics/PCB Mount.SLDPRT

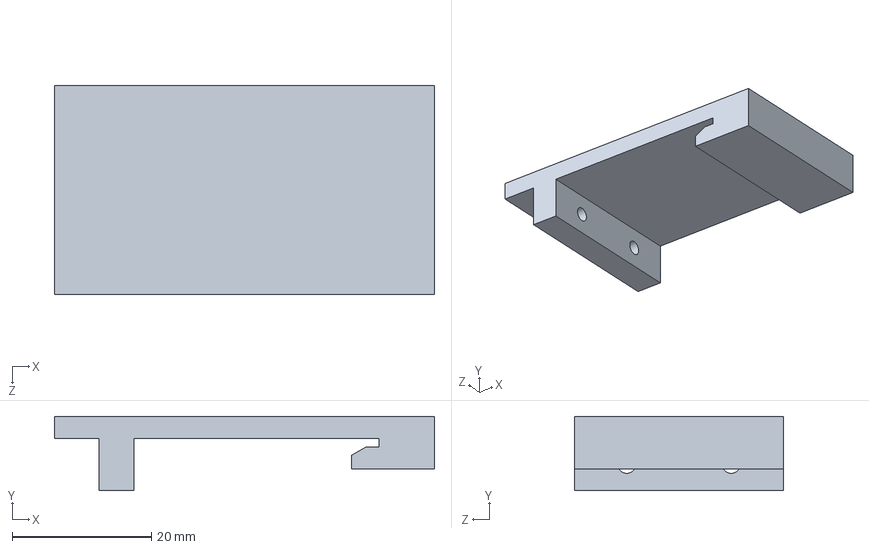
[picture p88: CAD file, 2025-11-05]
Bass Guitar Cad Models/S25/Electronics/PCB Mount.SLDPRT
54.6 x 10.7 x 30.0 mm
