ju8t1n203/Midi-Bass-Guitar/Bass Guitar Cad Models/S25/Electronics/Fret Board Cage.SLDPRT

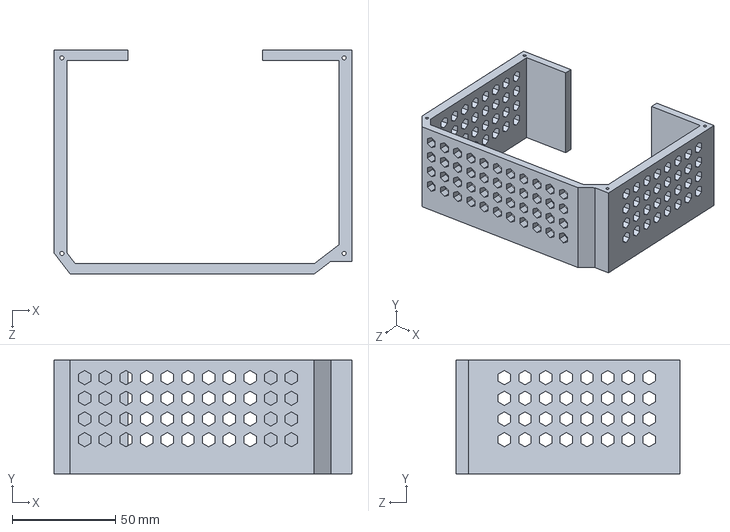
[picture p90: CAD file, 2025-11-05]
Bass Guitar Cad Models/S25/Electronics/Fret Board Cage.SLDPRT
144.1 x 55.0 x 108.4 mm
