ju8t1n203/Midi-Bass-Guitar/Bass Guitar Cad Models/S25/STLs/Bass Mount.STL

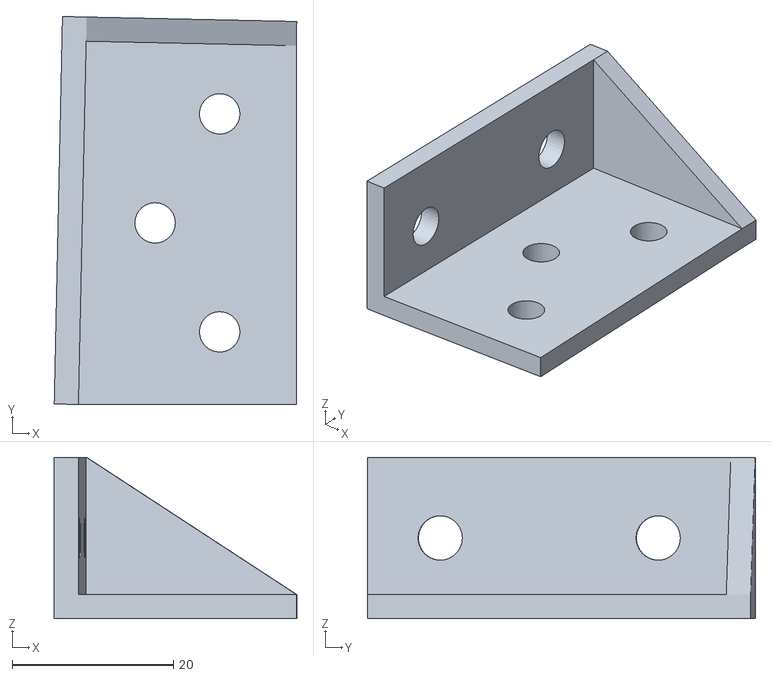
[picture p91: CAD file, 2025-11-05]
Bass Guitar Cad Models/S25/STLs/Bass Mount.STL
30.1 x 48.1 x 20.0
