ju8t1n203/Midi-Bass-Guitar/Bass Guitar Cad Models/S25/Electronics/Solenoid PCB Blank.SLDPRT

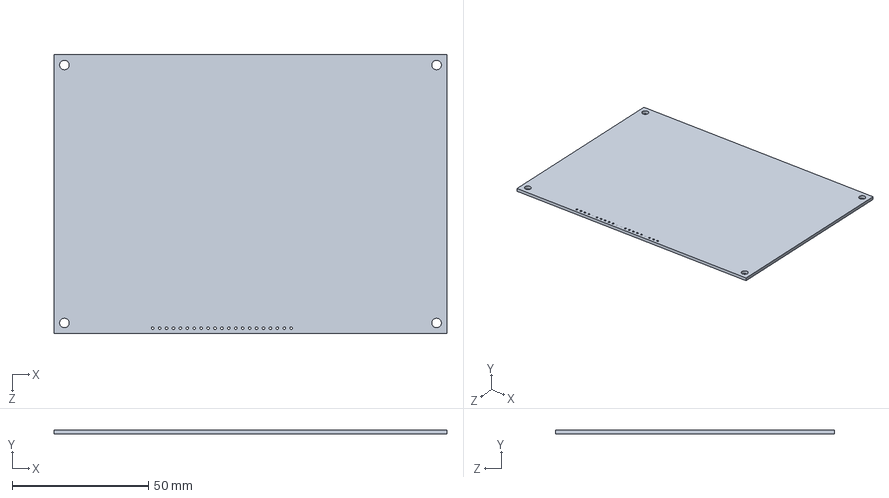
[picture p92: CAD file, 2025-11-05]
Bass Guitar Cad Models/S25/Electronics/Solenoid PCB Blank.SLDPRT
144.1 x 1.60 x 102.2 mm
