ju8t1n203/Midi-Bass-Guitar/Bass Guitar Cad Models/S25/Neck Support Brace.SLDPRT

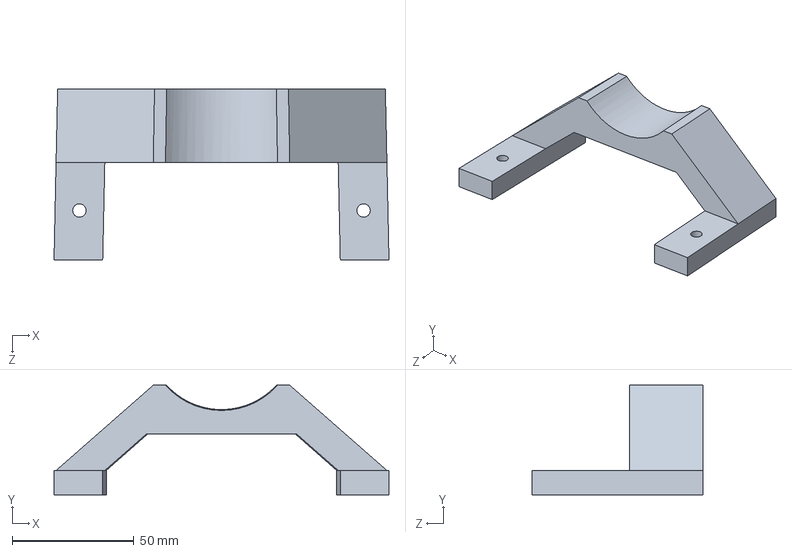
[picture p93: CAD file, 2025-11-05]
Bass Guitar Cad Models/S25/Neck Support Brace.SLDPRT
137.5 x 45.0 x 70.0 mm
