ju8t1n203/Midi-Bass-Guitar/Bass Guitar Cad Models/S25/Electronics/Motherboard PCB BLANK.SLDPRT

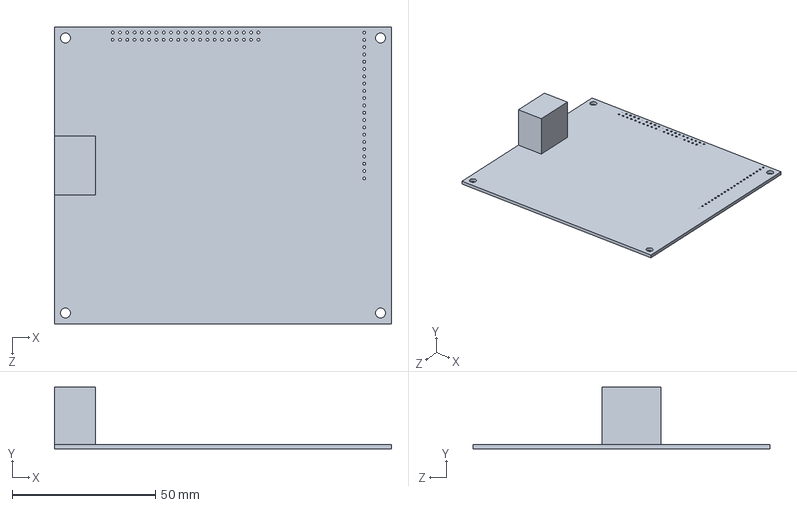
[picture p95: CAD file, 2025-11-05]
Bass Guitar Cad Models/S25/Electronics/Motherboard PCB BLANK.SLDPRT
117.5 x 21.6 x 103.5 mm
