ju8t1n203/Midi-Bass-Guitar/Bass Guitar Cad Models/S25/Pick Guard.SLDPRT

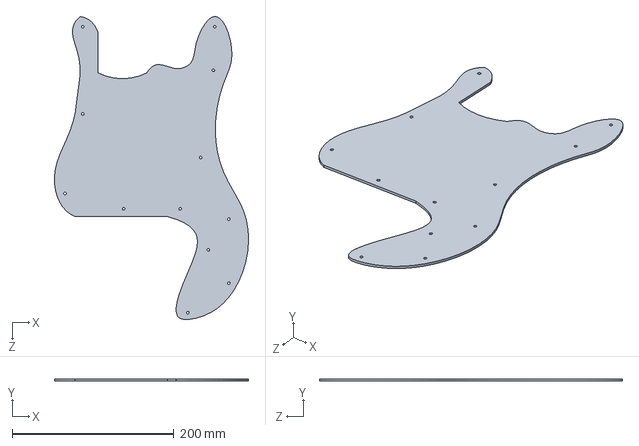
[picture p96: CAD file, 2025-11-05]
Bass Guitar Cad Models/S25/Pick Guard.SLDPRT
240.4 x 2.54 x 375.2 mm
