ju8t1n203/Midi-Bass-Guitar/Bass Guitar Cad Models/S25/Electronics/PCB Standoff.SLDPRT

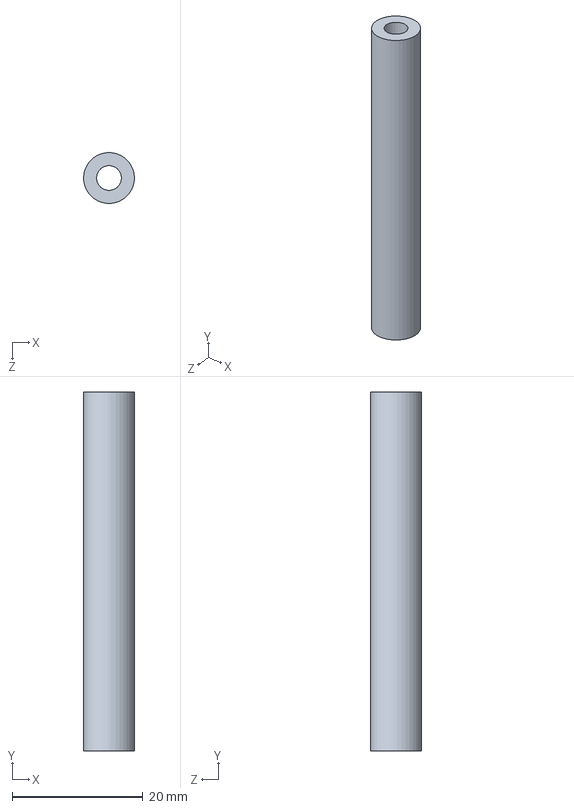
[picture p97: CAD file, 2025-11-05]
Bass Guitar Cad Models/S25/Electronics/PCB Standoff.SLDPRT
7.79 x 55.0 x 7.80 mm
