ju8t1n203/Midi-Bass-Guitar/Bass Guitar Cad Models/S25/Fret Bars/11th Fret Bar.SLDPRT

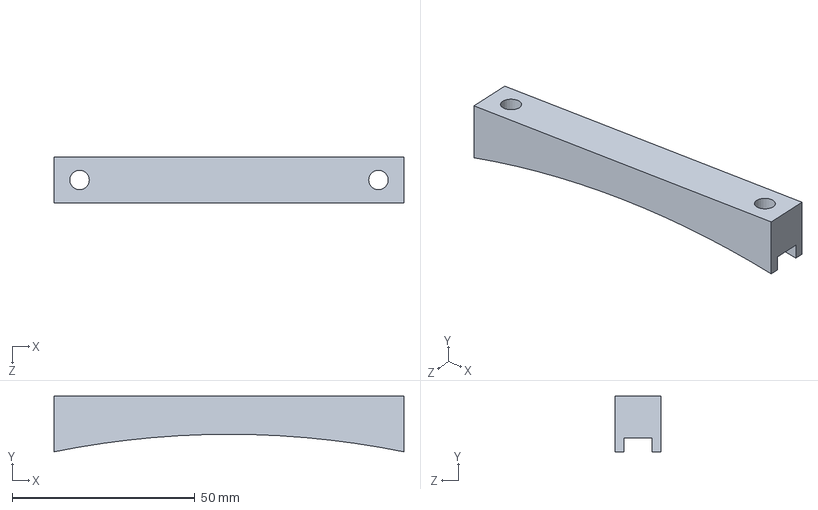
[picture p98: CAD file, 2025-11-05]
Bass Guitar Cad Models/S25/Fret Bars/11th Fret Bar.SLDPRT
95.8 x 15.2 x 12.7 mm
