ju8t1n203/Midi-Bass-Guitar/Bass Guitar Cad Models/S25/Solenoid Firing pin.SLDPRT

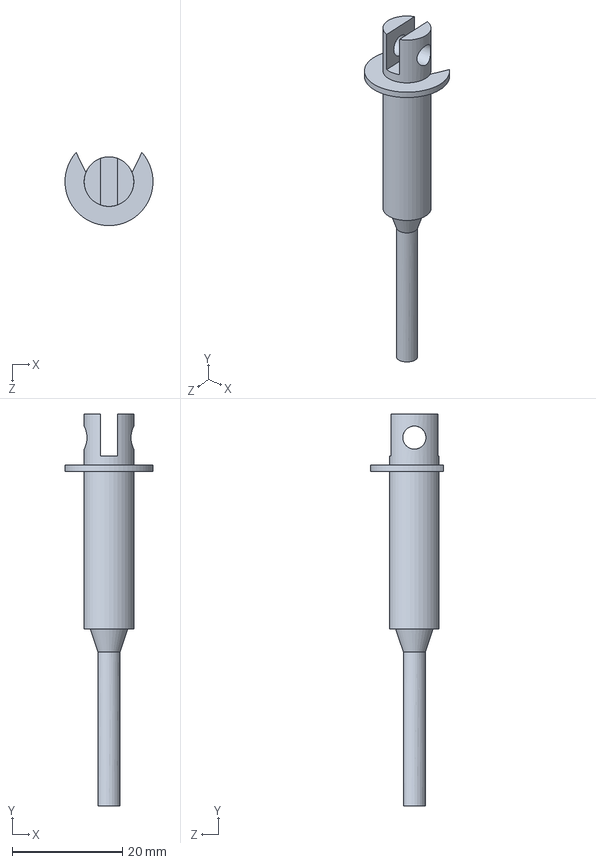
[picture p99: CAD file, 2025-11-05]
Bass Guitar Cad Models/S25/Solenoid Firing pin.SLDPRT
16.0 x 71.1 x 13.3 mm
