ju8t1n203/Midi-Bass-Guitar/Bass Guitar Cad Models/S25/90 Angle 2020 Bracket.SLDPRT

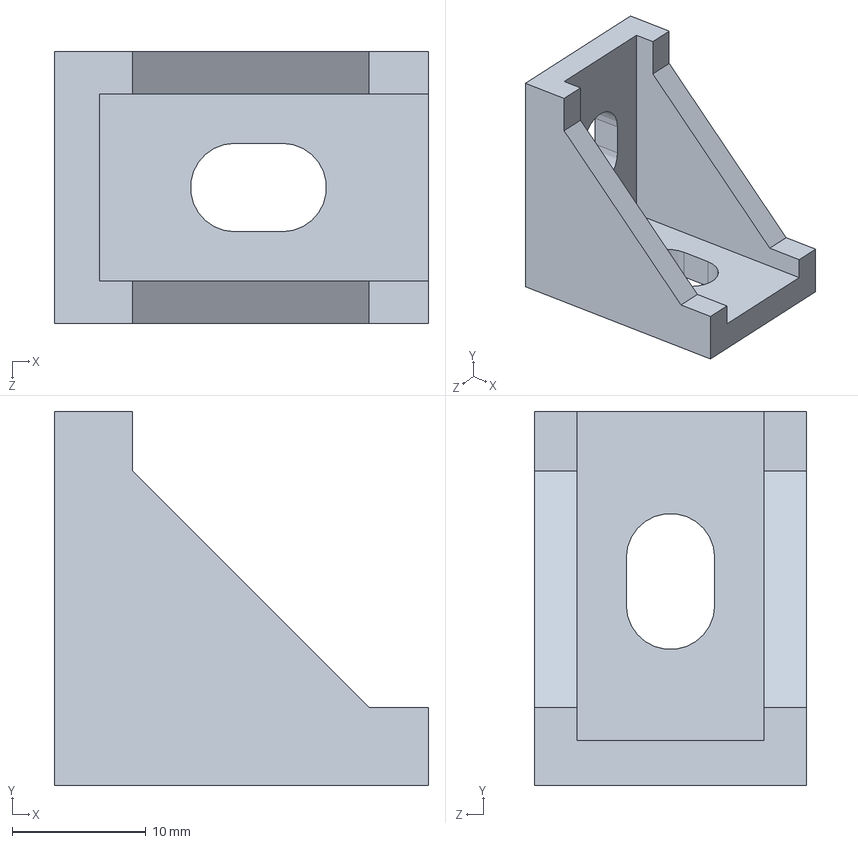
[picture p100: CAD file, 2025-11-05]
Bass Guitar Cad Models/S25/90 Angle 2020 Bracket.SLDPRT
27.9 x 27.9 x 20.3 mm
