ju8t1n203/Midi-Bass-Guitar/Bass Guitar Cad Models/S25/Fret Bars/First Fret Bar.SLDPRT

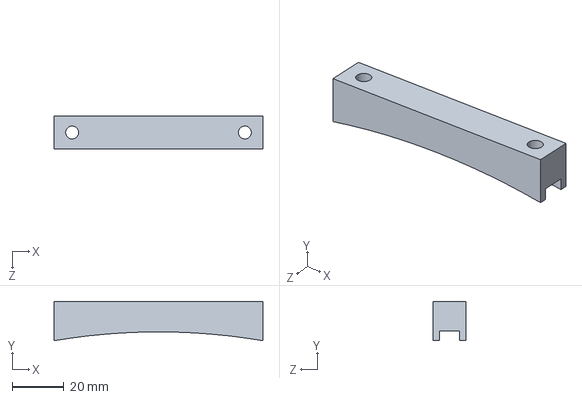
[picture p101: CAD file, 2025-11-05]
Bass Guitar Cad Models/S25/Fret Bars/First Fret Bar.SLDPRT
80.8 x 15.2 x 12.7 mm
