ju8t1n203/Midi-Bass-Guitar/Bass Guitar Cad Models/S25/P-Bass Neck.SLDPRT

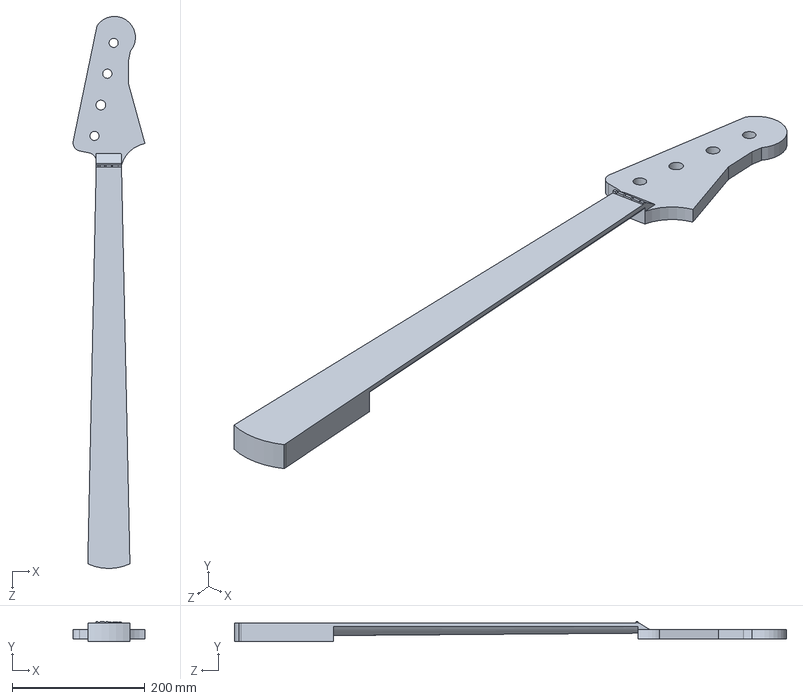
[picture p102: CAD file, 2025-11-05]
Bass Guitar Cad Models/S25/P-Bass Neck.SLDPRT
108.5 x 30.2 x 832.8 mm
