ju8t1n203/Midi-Bass-Guitar/Bass Guitar Cad Models/S25/Small Mounting Bracket A.SLDPRT

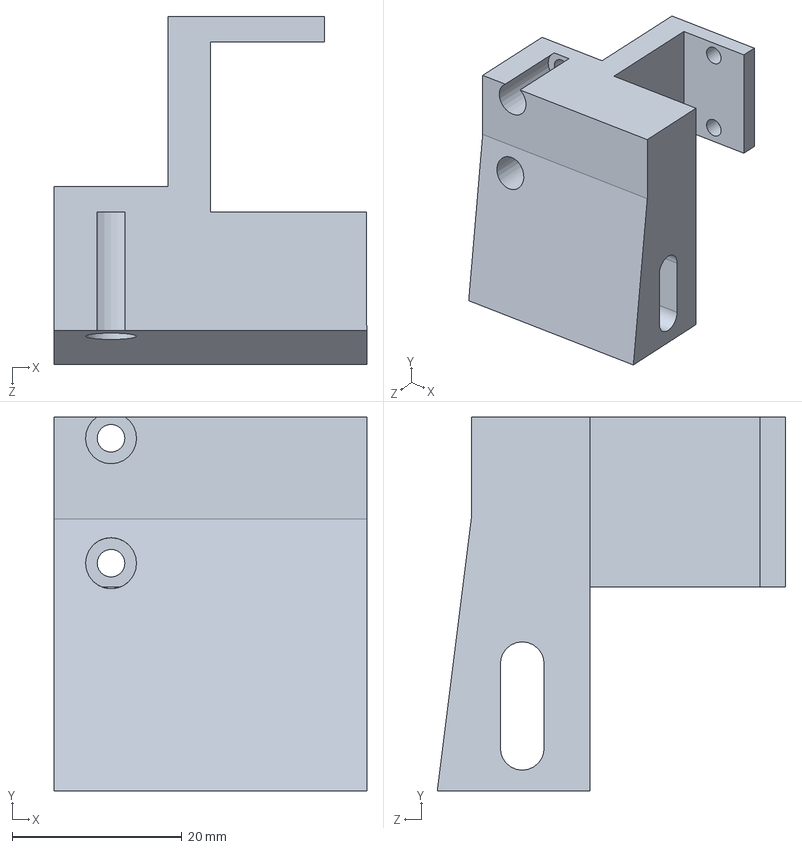
[picture p104: CAD file, 2025-11-05]
Bass Guitar Cad Models/S25/Small Mounting Bracket A.SLDPRT
36.8 x 44.0 x 41.0 mm
