ju8t1n203/Midi-Bass-Guitar/Bass Guitar Cad Models/S25/Bottom Support Bracket.SLDPRT

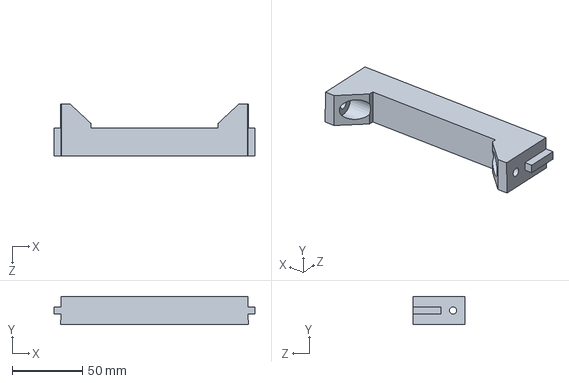
[picture p105: CAD file, 2025-11-05]
Bass Guitar Cad Models/S25/Bottom Support Bracket.SLDPRT
143.0 x 20.0 x 37.0 mm
