ju8t1n203/Midi-Bass-Guitar/Bass Guitar Cad Models/S25/Bridge Saddle.SLDPRT

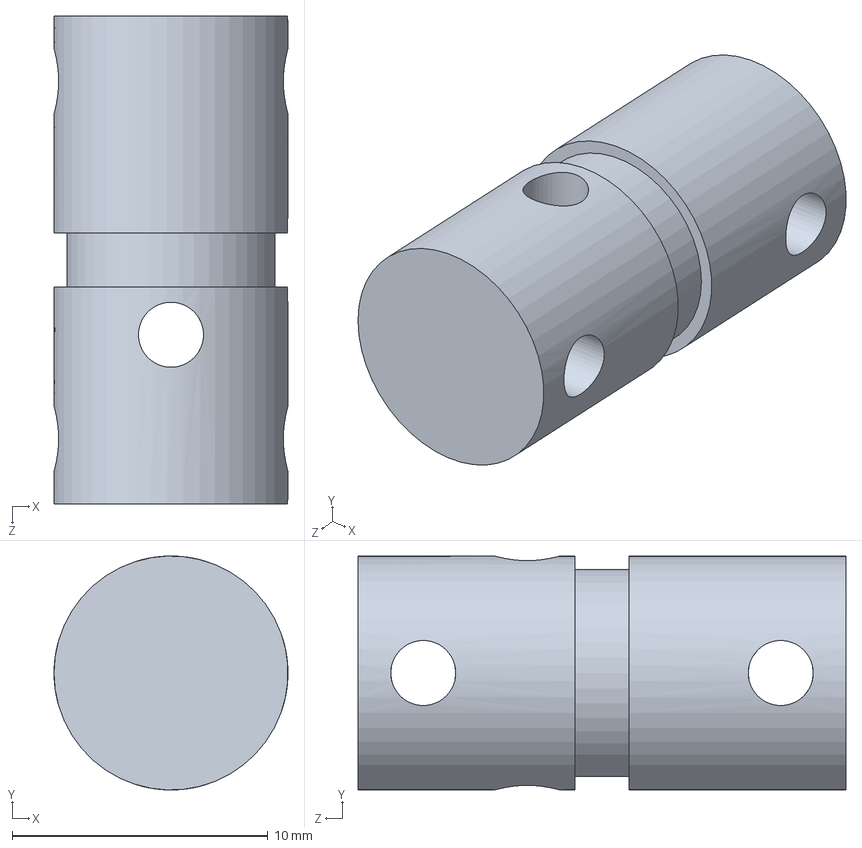
[picture p107: CAD file, 2025-11-05]
Bass Guitar Cad Models/S25/Bridge Saddle.SLDPRT
9.14 x 9.14 x 19.1 mm
