ju8t1n203/Midi-Bass-Guitar/Bass Guitar Cad Models/S25/Solenoid 2020 Mount.SLDPRT

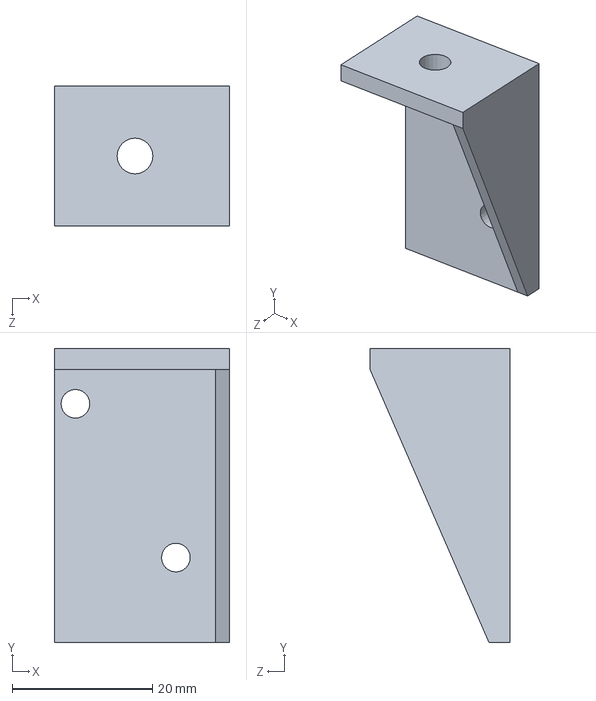
[picture p108: CAD file, 2025-11-05]
Bass Guitar Cad Models/S25/Solenoid 2020 Mount.SLDPRT
25.0 x 42.0 x 20.0 mm
