ju8t1n203/Midi-Bass-Guitar/Bass Guitar Cad Models/S25/Simplified Bridge.SLDPRT

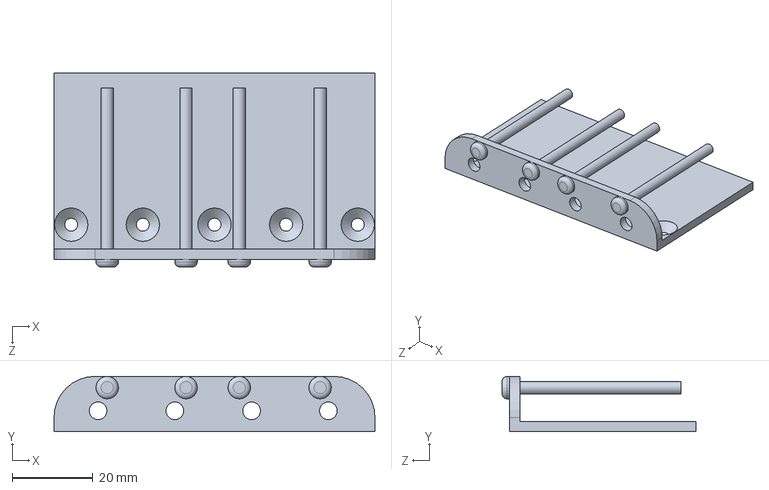
[picture p109: CAD file, 2025-11-05]
Bass Guitar Cad Models/S25/Simplified Bridge.SLDPRT
79.7 x 13.7 x 48.1 mm
