ju8t1n203/Midi-Bass-Guitar/Bass Guitar Cad Models/S25/2020 Extrusion.SLDPRT

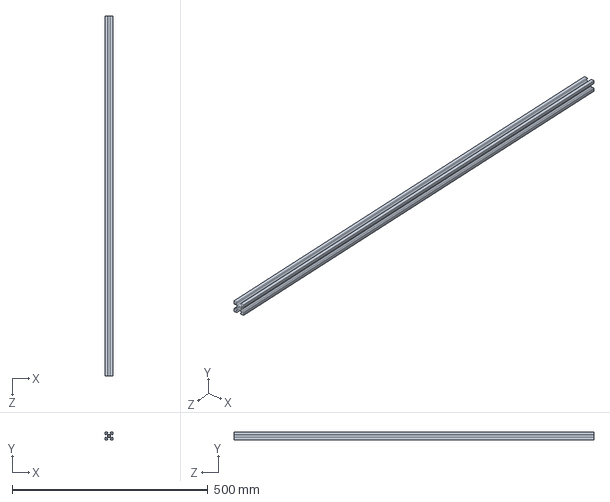
[picture p110: CAD file, 2025-11-05]
Bass Guitar Cad Models/S25/2020 Extrusion.SLDPRT
20.0 x 20.0 x 920.0 mm
