ju8t1n203/Midi-Bass-Guitar/Bass Guitar Cad Models/S25/4n Solenoid Body.SLDPRT

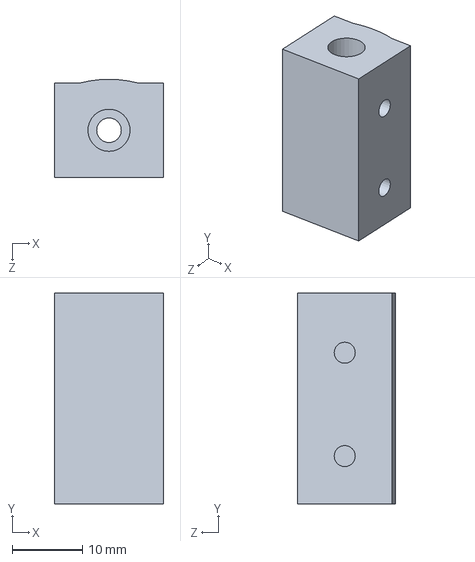
[picture p111: CAD file, 2025-11-05]
Bass Guitar Cad Models/S25/4n Solenoid Body.SLDPRT
15.5 x 30.0 x 14.0 mm
