ju8t1n203/Midi-Bass-Guitar/Bass Guitar Cad Models/S25/25n Solenoid Simple Body.SLDPRT

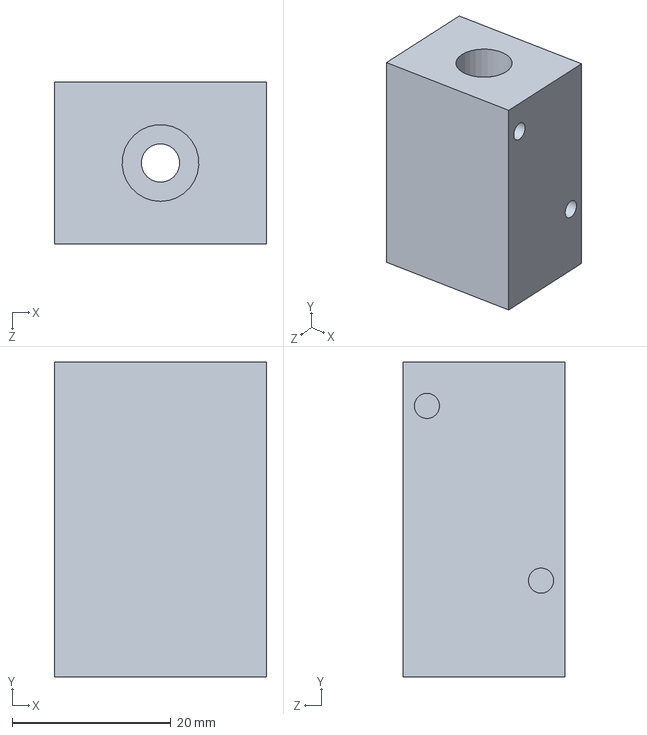
[picture p112: CAD file, 2025-11-05]
Bass Guitar Cad Models/S25/25n Solenoid Simple Body.SLDPRT
26.7 x 39.6 x 20.3 mm
