ju8t1n203/Midi-Bass-Guitar/(list of files, cad)

Other CAD files:
Bass Guitar Cad Models/S25/Fret Bars/20th Fret Bar.SLDPRT
Bass Guitar Cad Models/S25/Fret Bars/4th Fret Bar.SLDPRT
Bass Guitar Cad Models/S25/STLs/2nd Fret Bar.STL
Bass Guitar Cad Models/S25/Fret Bars/8th Fret Bar.SLDPRT
Bass Guitar Cad Models/S25/Fret Bars/18th Fret Bar.SLDPRT
Bass Guitar Cad Models/S25/Fret Bars/12th Fret Bar.SLDPRT
Bass Guitar Cad Models/S25/STLs/18th Fret Bar.STL
Bass Guitar Cad Models/S25/STLs/11th Fret Bar.STL
Bass Guitar Cad Models/S25/STLs/PCB Standoff.STL
Bass Guitar Cad Models/S25/Fret Bars/6th Fret Bar.SLDPRT
Bass Guitar Cad Models/S25/Fret Bars/10th Fret Bar.SLDPRT
Bass Guitar Cad Models/S25/STLs/Fret Board Cage.STL
Bass Guitar Cad Models/S25/Fret Bars/7th Fret Bar.SLDPRT
Bass Guitar Cad Models/S25/Fret Bars/9th Fret Bar.SLDPRT
Bass Guitar Cad Models/S25/STLs/First Fret Bar.STL
Bass Guitar Cad Models/S25/Bass Mount left.SLDPRT
Bass Guitar Cad Models/S25/STLs/3rd Fret Bar.STL
Bass Guitar Cad Models/S25/STLs/Solenoid Hori Mount.STL
Bass Guitar Cad Models/S25/STLs/DIN Rail Mounts.STL
Bass Guitar Cad Models/S25/Small Mounting Bracket D.SLDPRT
Bass Guitar Cad Models/S25/STLs/16th Fret Bar.STL
Bass Guitar Cad Models/F25/Fret/GenrealBar.ipt
Bass Guitar Cad Models/F25/Fret/OldVersions/AllFretBars.0003.ipt
Bass Guitar Cad Models/F25/Fret/OldVersions/GenrealBar.0006.ipt
Bass Guitar Cad Models/F25/Fret/OldVersions/SolenoidMount.0003.ipt
Bass Guitar Cad Models/F25/Fret/SolenoidMount.ipt
Bass Guitar Cad Models/S25/Drawings/2020 Extrusion 970mm Drawing.SLDDRW
Bass Guitar Cad Models/S25/Drawings/2020 Extrusion Short Drawing.SLDDRW
Bass Guitar Cad Models/S25/Drawings/25n Solenoid Simple Body Drawing.SLDDRW
Bass Guitar Cad Models/S25/Drawings/4n Solenoid Body Drawing.SLDDRW
Bass Guitar Cad Models/S25/Drawings/4n Solenoid Pin Drawings.SLDDRW
Bass Guitar Cad Models/S25/Drawings/Bass Mount Drawing.SLDDRW
Bass Guitar Cad Models/S25/Drawings/Bottom Support Bracket Drawing.SLDDRW
Bass Guitar Cad Models/S25/Drawings/Bridge Saddle Drawing.SLDDRW
Bass Guitar Cad Models/S25/Drawings/Muting Bracket Drawing.SLDDRW
Bass Guitar Cad Models/S25/Drawings/Neck Support Brace Drawing.SLDDRW
Bass Guitar Cad Models/S25/Drawings/P-Bass Body Drawing.SLDDRW
Bass Guitar Cad Models/S25/Drawings/P-Bass Neck Drawing.SLDDRW
Bass Guitar Cad Models/S25/Drawings/Pick Guard Drawing.SLDDRW
Bass Guitar Cad Models/S25/Drawings/Simplified Bridge Drawing.SLDDRW
Bass Guitar Cad Models/S25/Drawings/Small Mounting Bracket Drawing.SLDDRW
Bass Guitar Cad Models/S25/Drawings/Solenoid 2020 Mount Drawing.SLDDRW
Bass Guitar Cad Models/S25/Drawings/Solenoid Firing pin Drawing.SLDDRW
Bass Guitar Cad Models/S25/Drawings/Top Cross Support Drawing.SLDDRW
Bass Guitar Cad Models/S25/STLs/90 Angle 2020 Bracket.STL
Bass Guitar Cad Models/S25/STLs/Bottom Support Bracket.STL
Bass Guitar Cad Models/S25/STLs/Muting Bracket.STL
Bass Guitar Cad Models/S25/STLs/Muting Finger.STL
Bass Guitar Cad Models/S25/STLs/Neck Support Brace.STL
Bass Guitar Cad Models/S25/STLs/Small Mounting Bracket A.STL
Bass Guitar Cad Models/S25/STLs/Small Mounting Bracket D.STL
Bass Guitar Cad Models/S25/STLs/Small Mounting Bracket G.STL
Bass Guitar Cad Models/S25/STLs/Small Mounting Bracket.STL
Bass Guitar Cad Models/S25/STLs/Solenoid 2020 Mount.STL
Bass Guitar Cad Models/S25/STLs/Top Cross Support.STL
IR_MIDI/CAD/OldVersions/TxCeilingMount.0001.ipt
IR_MIDI/CAD/TxCeilingMount.ipt
