ju8t1n203/Midi-Bass-Guitar/F25_Report/Tx[needtofinish].pdf

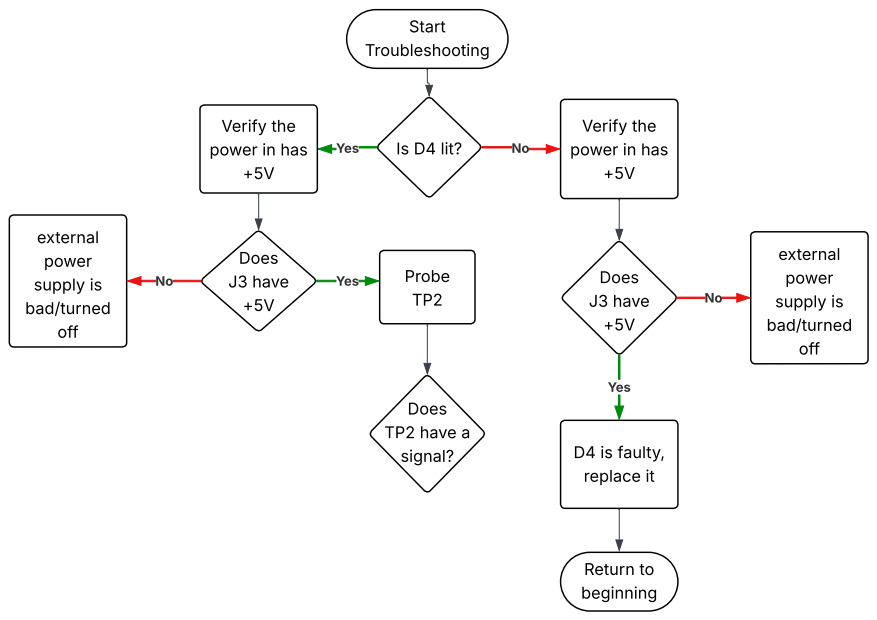
[picture p115: page 1]
Start Troubleshooting; Yes; Is D4 lit?; Does J3 have +5V; external power supply is bad/turned off; D4 is faulty, replace it; Return to beginning; Probe TP2; Does TP2 have a signal?

Verify the
power in has
