ju8t1n203/Midi-Bass-Guitar/Bass Guitar Cad Models/S25/Drawing PDFs/4n Solenoid Pin Drawings.pdf

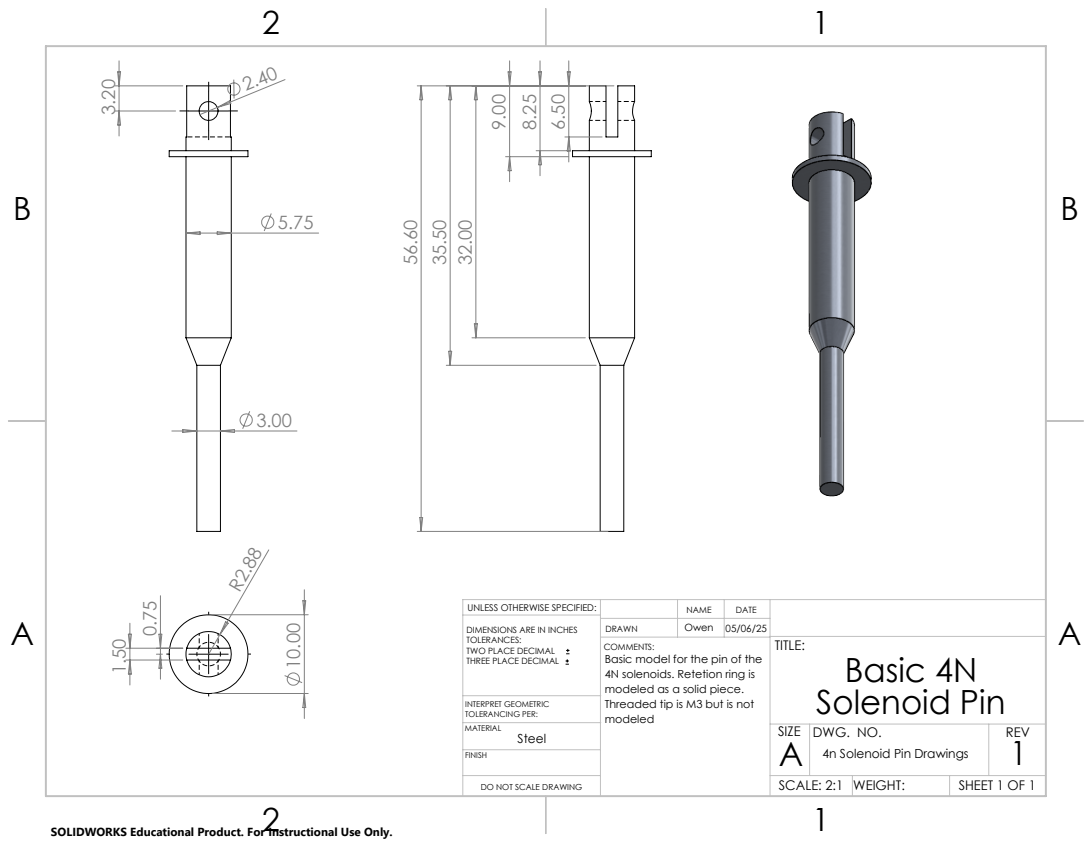
[picture p118: page 1]
SHEET 1 OF 1; SCALE: 2:1; WEIGHT:; INTERPRET GEOMETRIC TOLERANCING PER:

UNLESS OTHERWISE SPECIFIED: | | NAME | DATE
DIMENSIONS ARE IN INCHES TOLERANCES: TWO PLACE DECIMAL THREE PLACE DECIMAL | DRAWN | Owen | 05/06/25

COMMENTS: Basic model for the pin of the 4N solenoids. Retetion ring is modeled as a solid piece. Threaded tip is M3 but is not modeled | | | TITLE: Basic 4N Solenoid Pin

MATERIAL Steel | | SIZE A | DWG. NO. 4n Solenoid Pin Drawings | REV 1

DO NOT SCALE DRAWING

SOLIDWORKS Educational Product. For Instructional Use Only.
