ju8t1n203/Midi-Bass-Guitar/Bass Guitar Cad Models/S25/Drawing PDFs/Bottom Support Bracket Drawing.pdf

B B

2

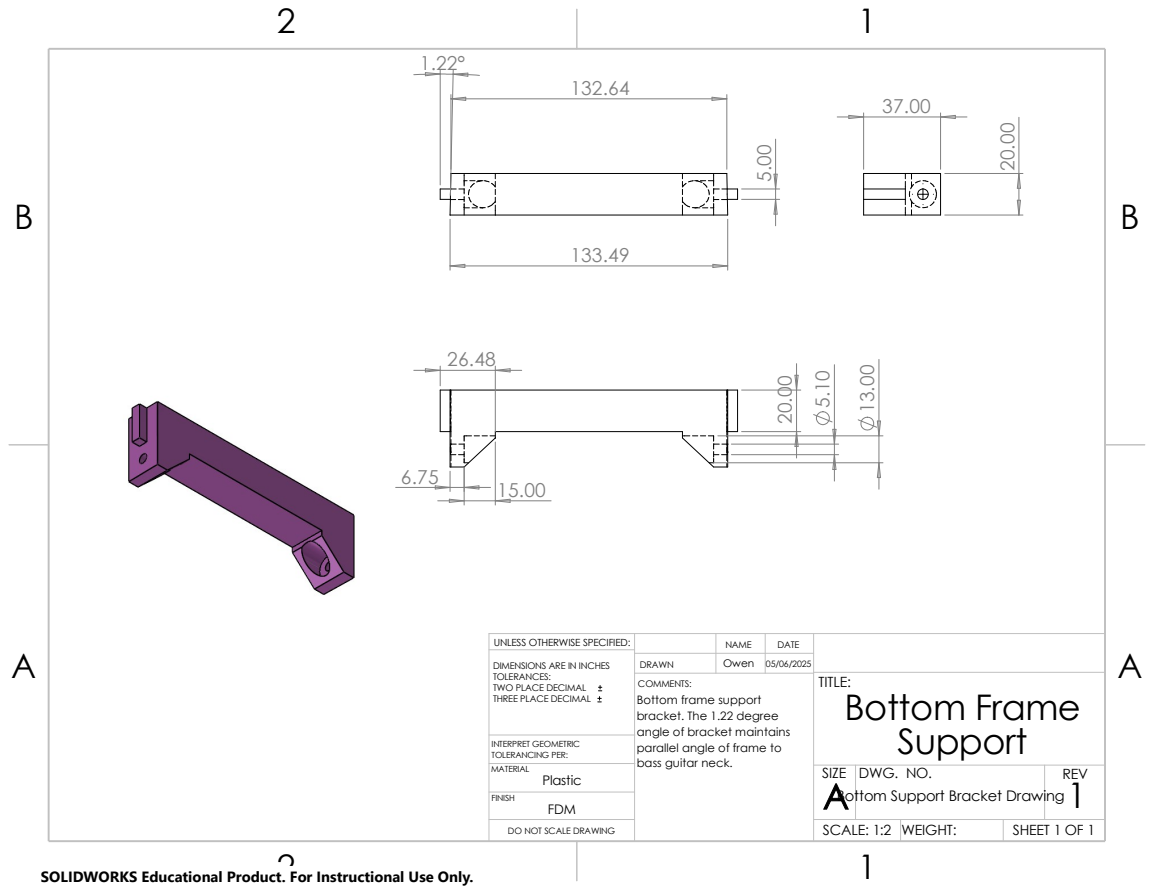
[picture p120: page 1]
A A DRAWN; INTERPRET GEOMETRIC; SHEET 1 OF 1; WEIGHT:; SCALE: 1:2; FDM; FINISH; TOLERANCING PER:; bass guitar neck.

UNLESS OTHERWISE SPECIFIED: | | NAME | DATE
DIMENSIONS ARE IN INCHES TOLERANCES: TWO PLACE DECIMAL THREE PLACE DECIMAL | | Owen | 05/06/2025
COMMENTS: Bottom frame support bracket. The 1.22 degree angle of bracket maintains parallel angle of frame to | | | TITLE: Bottom Frame Support

MATERIAL Plastic | | SIZE A Bottom Support Bracket Drawing | DWG. NO. | REV 1

DO NOT SCALE DRAWING

SOLIDWORKS Educational Product. For Instructional Use Only.
