ju8t1n203/Midi-Bass-Guitar/Bass Guitar Cad Models/S25/Drawing PDFs/Neck Support Brace Drawing.pdf

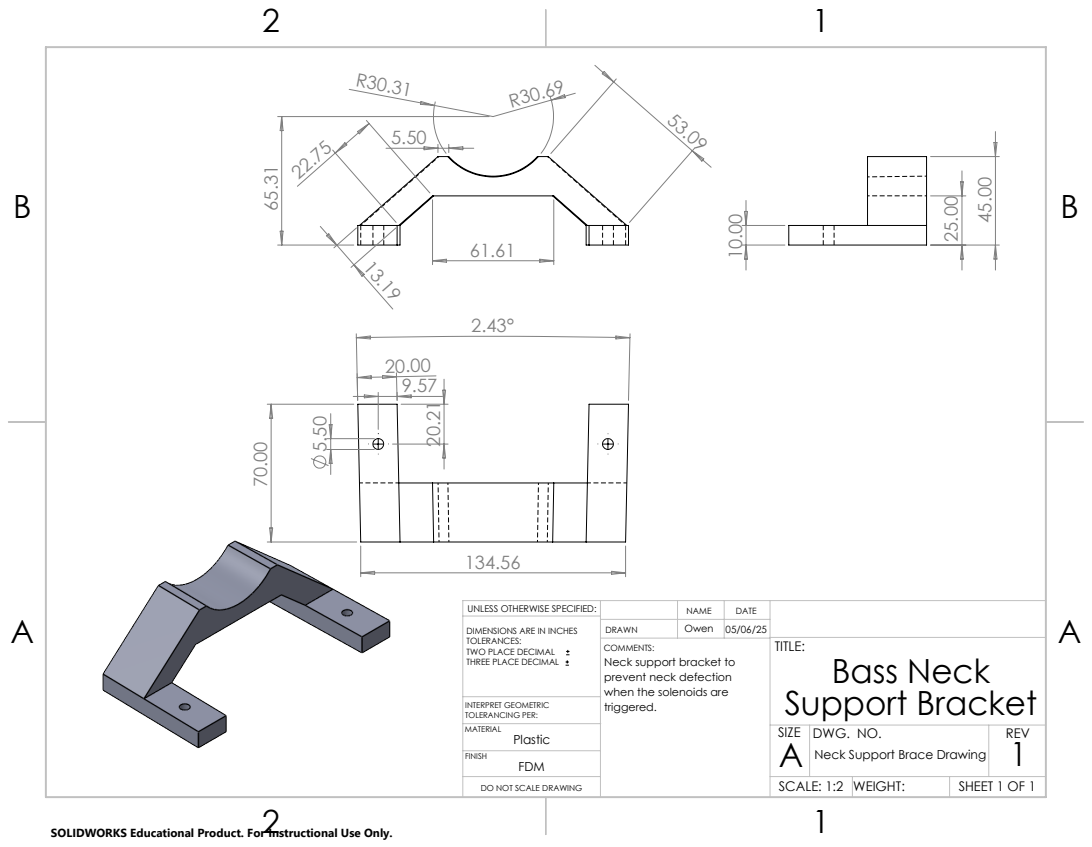
[picture p123: page 1]
SHEET 1 OF 1; SCALE: 1:2; WEIGHT:; FDM FINISH; INTERPRET GEOMETRIC TOLERANCING PER:

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

COMMENTS: Neck support bracket to prevent neck defection when the solenoids are triggered. | | | TITLE: Bass Neck Support Bracket

MATERIAL Plastic | | SIZE A | DWG. NO. Neck Support Brace Drawing | REV 1

DO NOT SCALE DRAWING

SOLIDWORKS Educational Product. For Instructional Use Only.
