ju8t1n203/Midi-Bass-Guitar/Solenoid Breakout Board/UniversalSolenoidRelay/UniversalSolenoidRelay.kicad_pcb

## KiCad design Solenoid Breakout Board/UniversalSolenoidRelay/UniversalSolenoidRelay.kicad_pcb (2025-11-16)

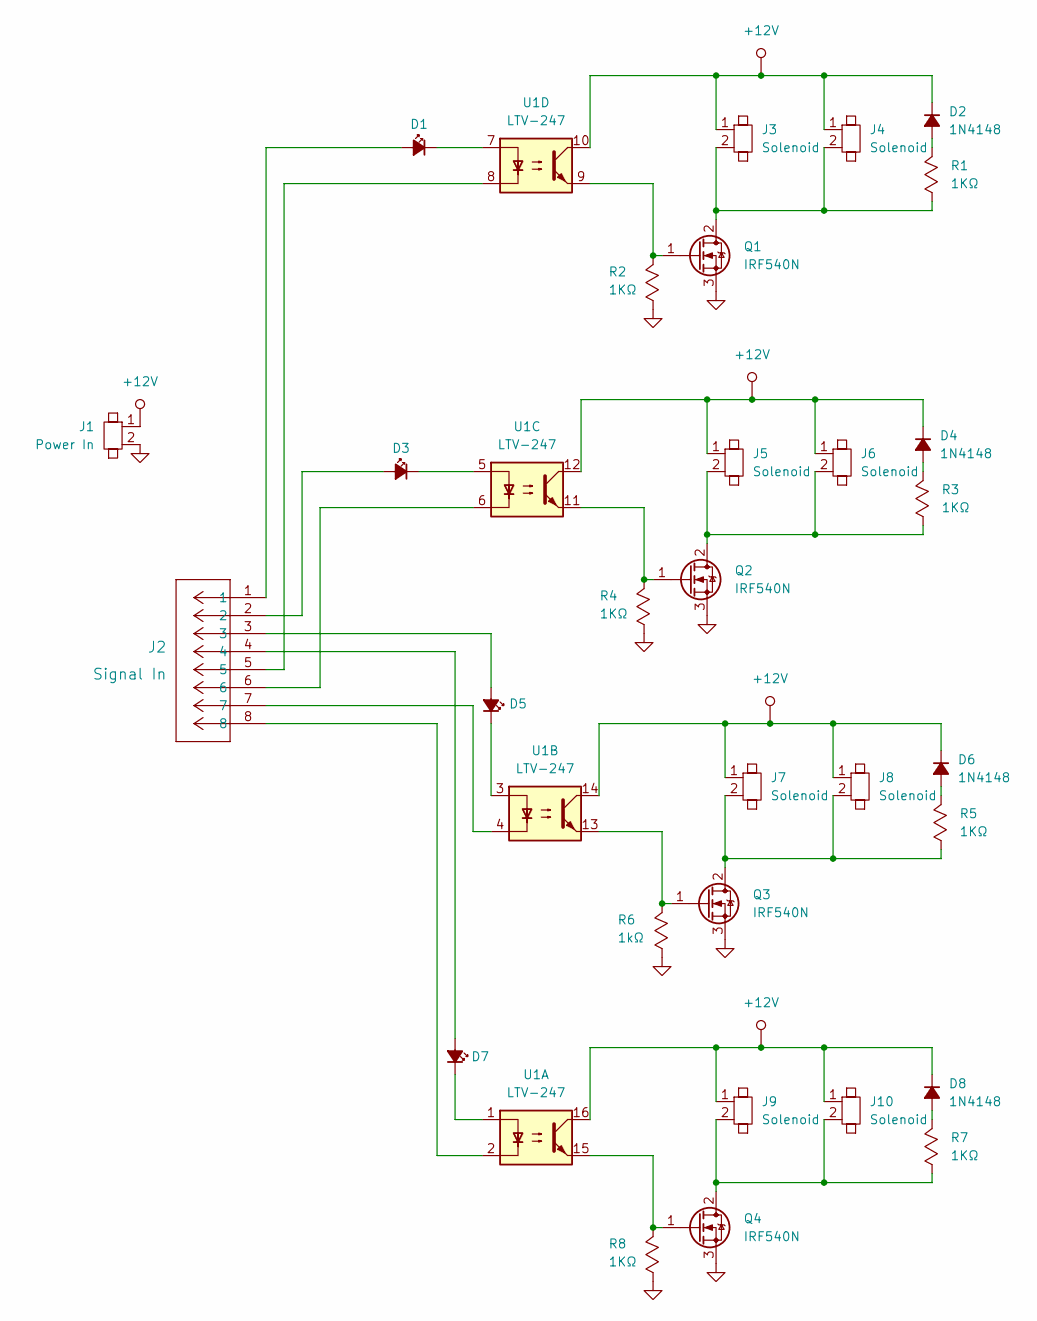
[picture p128: schematic UniversalSolenoidRelay.kicad_sch]

Parts:
D1, D3, D5, D7: LED; D_0805
D2, D4, D6, D8: 1N4148; D_0805
J1: Power In; 2PinMolex
J2: Signal In; 8PinMolex_3.00mmPitch
J3, J4, J5, J6, J7, J8, J9, J10: Solenoid; 2PinMolex
Q1, Q2, Q3, Q4: IRF540N; TO-220-3_Vertical
R1, R2, R3, R4, R5, R7, R8: 1KΩ; C_0805
R6: 1kΩ; C_0805
U1: LTV-247; SOP-16_4.4x10.4mm_P1.27mm

Connections:
GND: J1.2, Q1.3 (S), Q2.3 (S), Q3.3 (S), Q4.3 (S), R2.1, R4.1, R6.1, R8.1
unnamed: D1.2 (A), J2.1
unnamed: D1.1 (K), U1.7
unnamed: D2.2 (A), R1.2
unnamed: D3.2 (A), J2.2
unnamed: D3.1 (K), U1.5
unnamed: D4.2 (A), R3.2
unnamed: D5.2 (A), J2.3
unnamed: D5.1 (K), U1.3
unnamed: D6.2 (A), R5.2
unnamed: D7.2 (A), J2.4
unnamed: D7.1 (K), U1.1
unnamed: D8.2 (A), R7.2
unnamed: D2.1 (K), D4.1 (K), D6.1 (K), D8.1 (K), J1.1, J3.1, J4.1, J5.1, J6.1, J7.1, J8.1, J9.1, J10.1, U1.10, U1.12, U1.14, U1.16
unnamed: J2.5, U1.8
unnamed: J2.6, U1.6
unnamed: J2.7, U1.4
unnamed: J2.8, U1.2
unnamed: J3.2, J4.2, Q1.2 (D), R1.1
unnamed: Q1.1 (G), R2.2, U1.9
unnamed: J5.2, J6.2, Q2.2 (D), R3.1
unnamed: Q2.1 (G), R4.2, U1.11
unnamed: J7.2, J8.2, Q3.2 (D), R5.1
unnamed: Q3.1 (G), R6.2, U1.13
unnamed: J9.2, J10.2, Q4.2 (D), R7.1
unnamed: Q4.1 (G), R8.2, U1.15

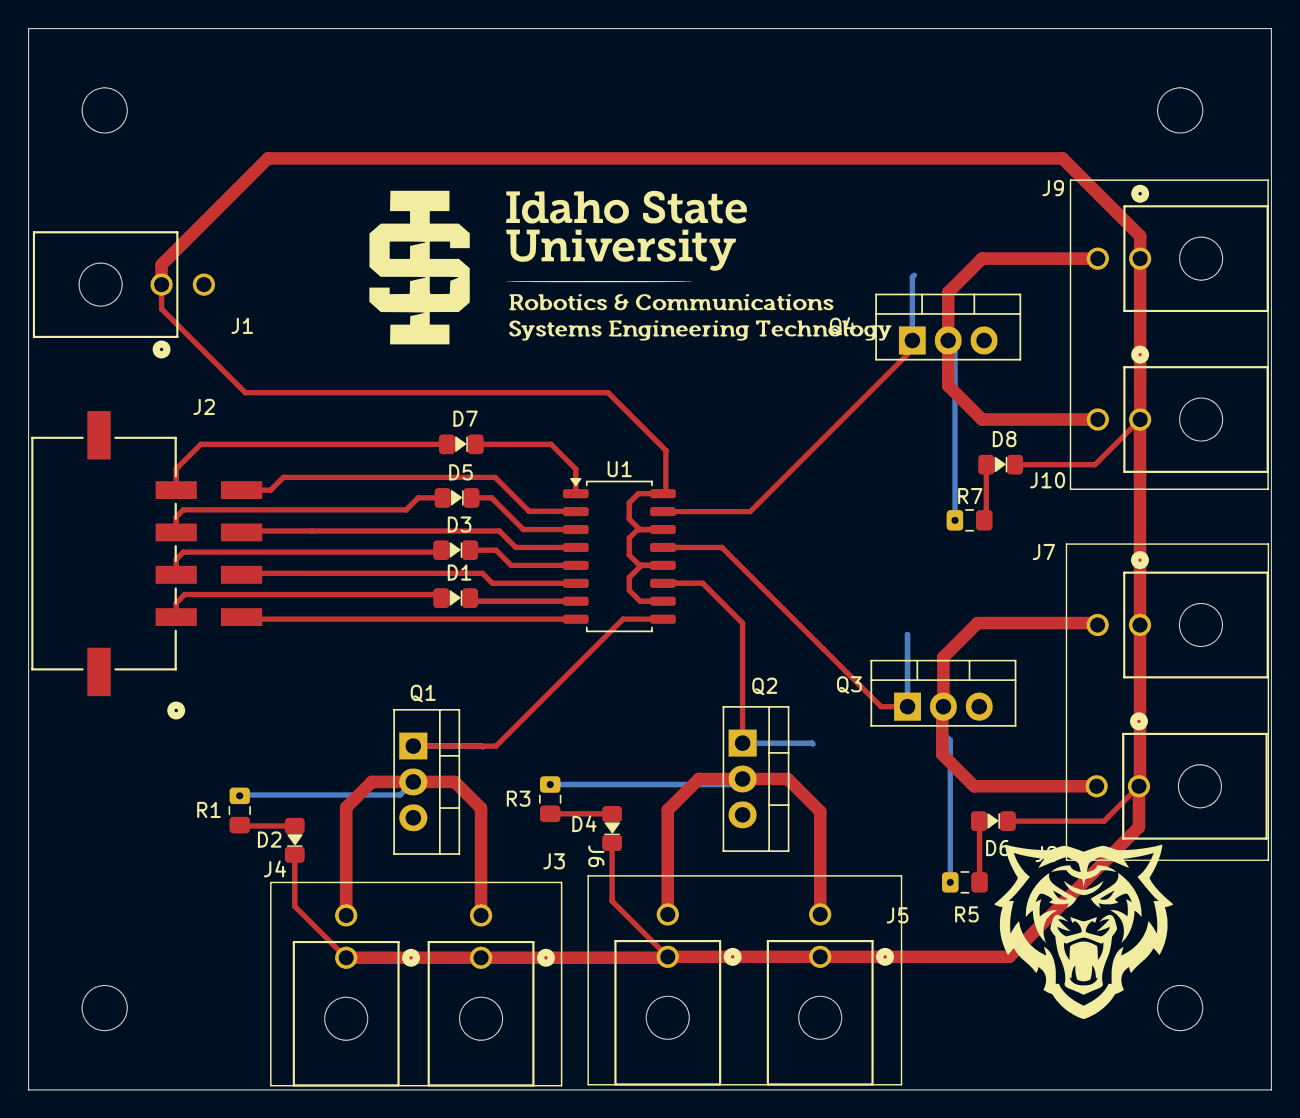
[picture p129: board UniversalSolenoidRelay.kicad_pcb from above]

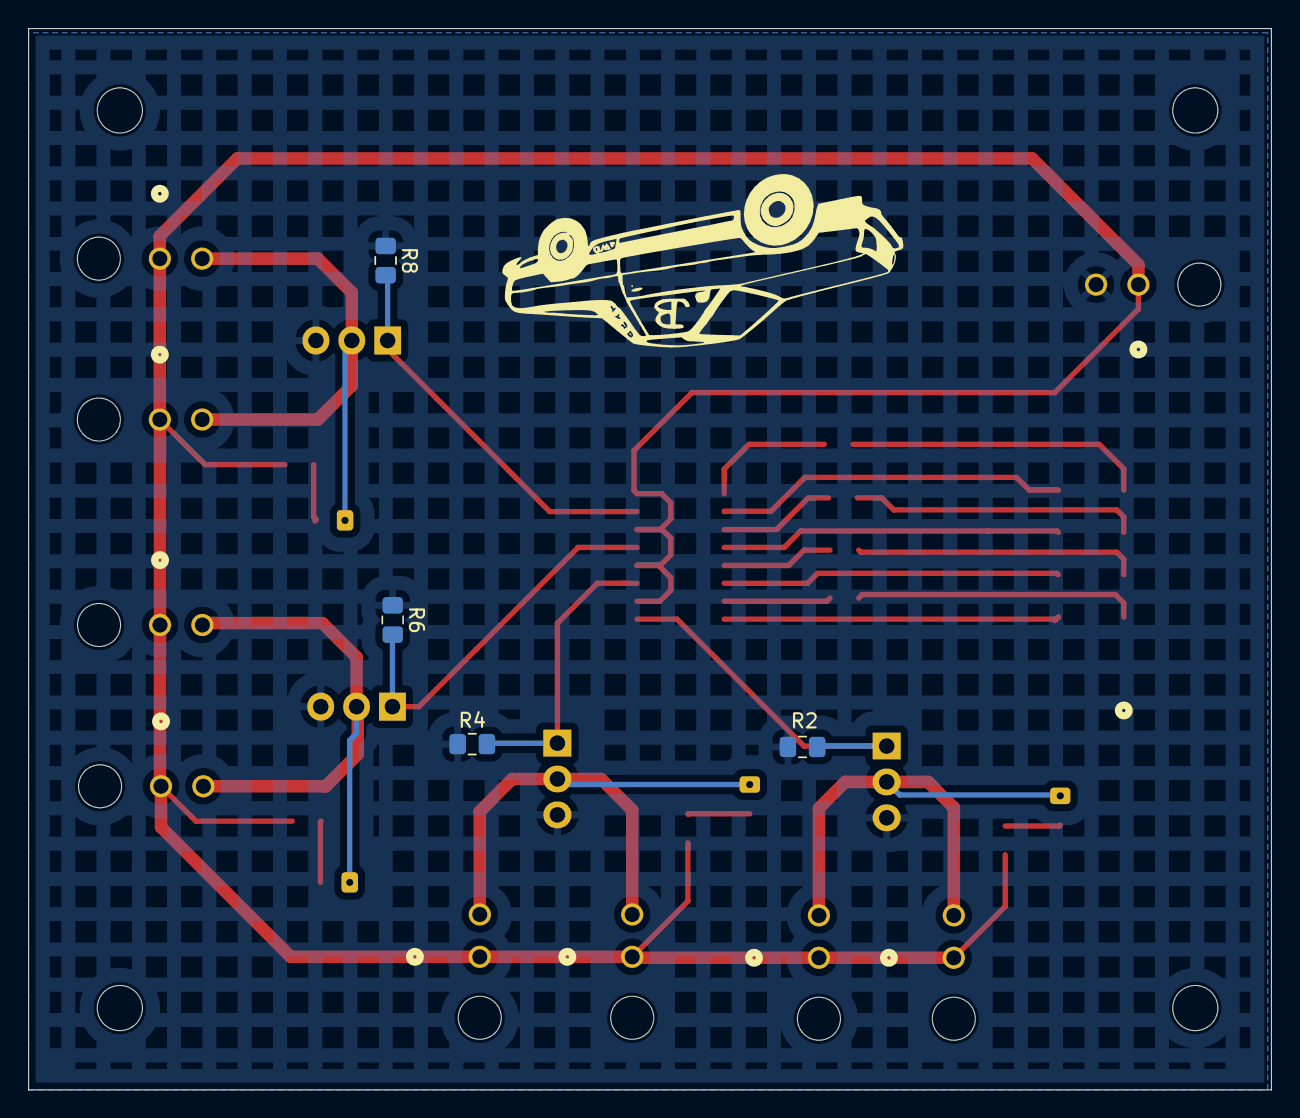
[picture p130: board UniversalSolenoidRelay.kicad_pcb from below]

Board: 2 copper layers, 88.1 x 75.2 mm, 31 parts (4 on the bottom side), 26 nets.
