ju8t1n203/Midi-Bass-Guitar/UniversalMaster/UMaster/UMaster.kicad_pcb

## KiCad design UniversalMaster/UMaster/UMaster.kicad_pcb (2025-11-15)

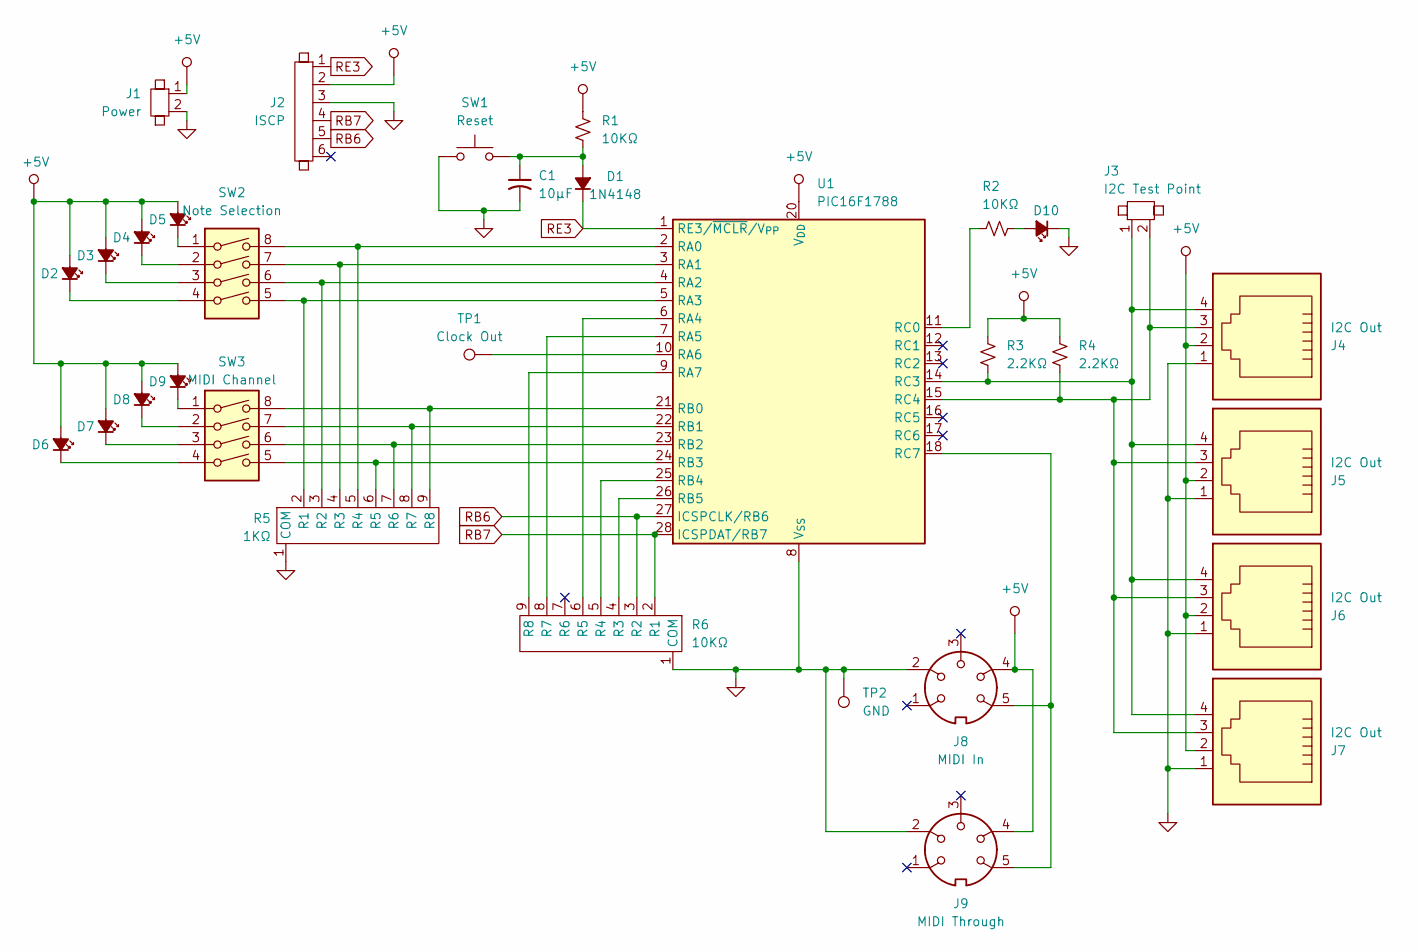
[picture p135: schematic UMaster.kicad_sch]

Parts:
C1: 10µF; C_Radial_D6.3mm_H11.0mm_P2.50mm
D1: 1N4148; D_0805
D2, D3, D4, D5, D6, D7, D8, D9, D10: LED_Small_Filled; D_0805
J1: Power; 2PinMolex
J2: ISCP; 1X6_100mil_Header
J3: I2C Test Point; 1X2_100mil_Header
J4, J5, J6, J7: I2C Out; RJ11
J8: MIDI In; DIN-5PIN_MIDI
J9: MIDI Through; DIN-5PIN_MIDI
R1, R2: 10KΩ; C_0805
R3, R4: 2.2KΩ; C_0805
R5: 1KΩ; 1x9_100mil_Header
R6: 10KΩ; 1x9_100mil_Header
SW1: Reset; SW_PUSH_6mm
SW2: Note Selection; DIP-8_W7.62mm
SW3: MIDI Channel; DIP-8_W7.62mm
TP1: Clock Out; 1X1_100mil_Header
TP2: GND; 1X1_100mil_Header
U1: PIC16F1788; QFN-28-1EP_6x6mm_P0.65mm_EP4.25x4.25mm

Connections:
GND: C1.2, D10.1 (K), J1.2, J2.3, J4.1, J5.1, J6.1, J7.1, J8.2, J9.2, R5.1 (COM), R6.1 (COM), SW1.1, TP2.1, U1.8 (V_{SS}), U1.19 (V_{SS})
unnamed: C1.1, D1.2 (A), R1.2, SW1.2
unnamed: D2.1 (K), SW2.4
unnamed: D3.1 (K), SW2.3
unnamed: D4.1 (K), SW2.2
unnamed: D5.1 (K), SW2.1
unnamed: D6.1 (K), SW3.4
unnamed: D7.1 (K), SW3.3
unnamed: D8.1 (K), SW3.2
unnamed: D9.1 (K), SW3.1
unnamed: D10.2 (A), R2.2
unnamed: R5.2 (R1), SW2.5, U1.5 (RA3)
unnamed: R5.3 (R2), SW2.6, U1.4 (RA2)
unnamed: R5.4 (R3), SW2.7, U1.3 (RA1)
unnamed: R5.5 (R4), SW2.8, U1.2 (RA0)
unnamed: R5.6 (R5), SW3.5, U1.24 (RB3)
unnamed: R5.7 (R6), SW3.6, U1.23 (RB2)
unnamed: R5.8 (R7), SW3.7, U1.22 (RB1)
unnamed: R5.9 (R8), SW3.8, U1.21 (RB0)
unnamed: R6.4 (R3), U1.26 (RB5)
unnamed: R6.5 (R4), U1.25 (RB4)
unnamed: R6.6 (R5), U1.6 (RA4)
unnamed: R6.8 (R7), U1.7 (RA5)
unnamed: R6.9 (R8), U1.9 (RA7)
unnamed: TP1.1, U1.10 (RA6)
unnamed: R2.1, U1.11 (RC0)
unnamed: J3.1, J4.4, J5.4, J6.4, J7.4, R3.2, U1.14 (RC3)
unnamed: J3.2, J4.3, J5.3, J6.3, J7.3, R4.2, U1.15 (RC4)
unnamed: J8.5, J9.5, U1.18 (RC7)
RB6: J2.5, R6.3 (R2), U1.27 (ICSPCLK/RB6)
RB7: J2.4, R6.2 (R1), U1.28 (ICSPDAT/RB7)
RE3: D1.1 (K), J2.1, U1.1 (RE3/~MCLR/V_{PP})

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
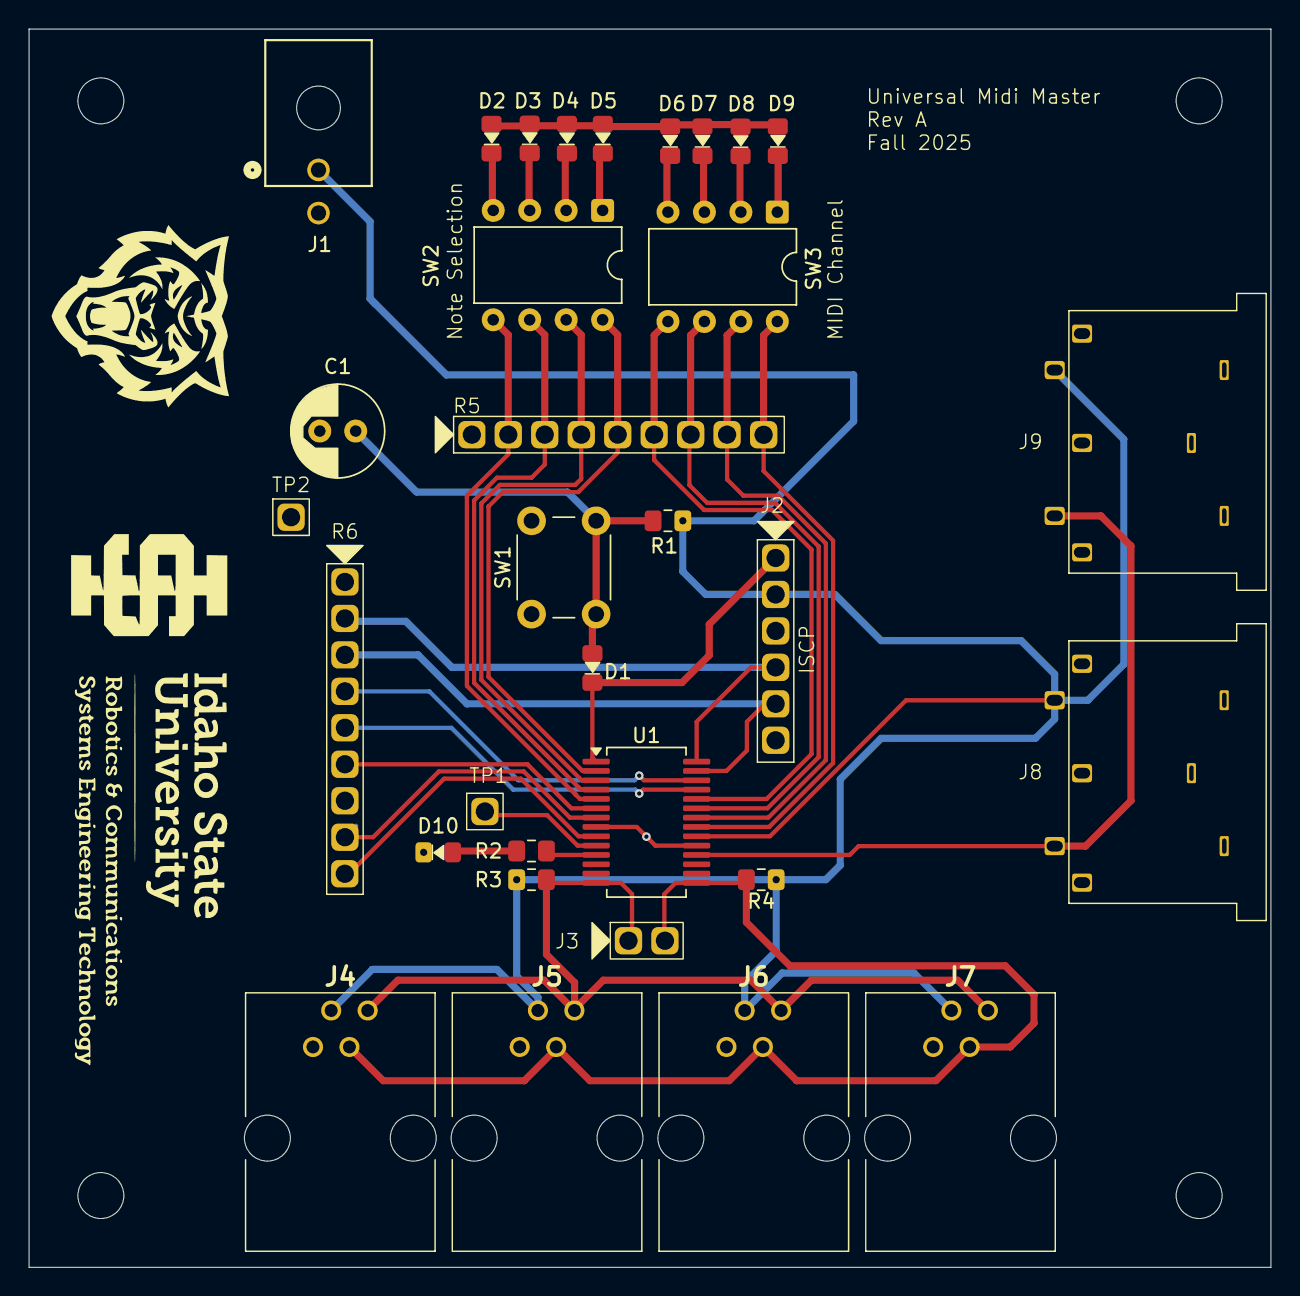
[picture p136: board UMaster.kicad_pcb from above]

Board: 2 copper layers, 86.5 x 86.2 mm, 32 parts (0 on the bottom side), 34 nets.
