ju8t1n203/Midi-Bass-Guitar/FretSlave/FretSlaveV2/FretSlaveV2.kicad_sch

## KiCad design FretSlave/FretSlaveV2/FretSlaveV2.kicad_sch (2025-11-14)

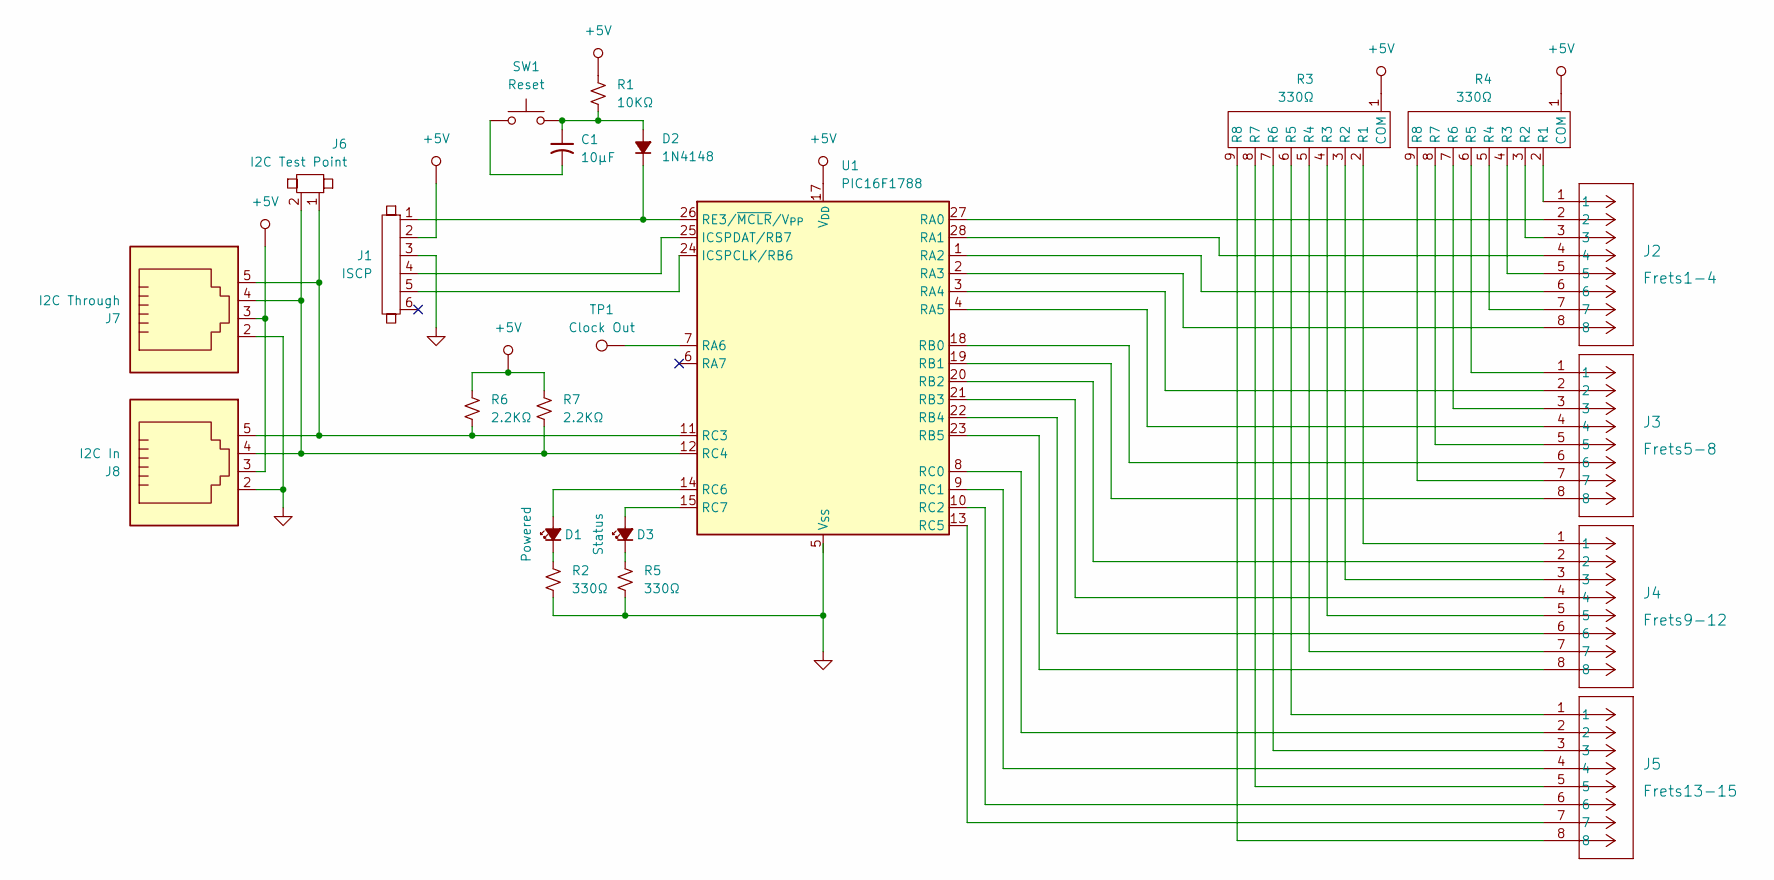
[picture p137: schematic FretSlaveV2.kicad_sch]

Parts:
C1: 10µF
D1: Powered
D2: 1N4148
D3: Status
J1: ISCP
J2: Frets1-4; CONN_SD-43045-004_08_MOL
J3: Frets5-8; CONN_SD-43045-004_08_MOL
J4: Frets9-12; CONN_SD-43045-004_08_MOL
J5: Frets13-15; CONN_SD-43045-004_08_MOL
J6: I2C Test Point; 1X2_100mil_Header
J7: I2C Through; RJ11
J8: I2C In; RJ11
R1: 10KΩ
R2, R3, R4, R5: 330Ω
R6, R7: 2.2KΩ; C_0805
SW1: Reset
TP1: Clock Out
U1: PIC16F1788; QFN-28-1EP_6x6mm_P0.65mm_EP4.25x4.25mm

Connections:
+5V: J1.2, J7.3, J8.3, R1.1, R3.1 (COM), R4.1 (COM), R6.1, R7.1, U1.17 (V_{DD})
GND: J1.3, J7.2, J8.2, R2.2, R5.2
unnamed: C1.1, D2.2 (A), R1.2, SW1.2
unnamed: C1.2, SW1.1
unnamed: D1.1 (K), R2.1
unnamed: D1.2 (A), U1.14 (RC6)
unnamed: D2.1 (K), J1.1, U1.26 (RE3/~MCLR/V_{PP})
unnamed: D3.1 (K), R5.1
unnamed: D3.2 (A), U1.15 (RC7)
unnamed: J1.4, U1.25 (ICSPDAT/RB7)
unnamed: J1.5, U1.24 (ICSPCLK/RB6)
unnamed: J2.1, R4.2 (R1)
unnamed: J2.2, U1.27 (RA0)
unnamed: J2.3, R4.3 (R2)
unnamed: J2.4, U1.28 (RA1)
unnamed: J2.5, R4.4 (R3)
unnamed: J2.6, U1.1 (RA2)
unnamed: J2.7, R4.5 (R4)
unnamed: J2.8, U1.2 (RA3)
unnamed: J3.1, R4.6 (R5)
unnamed: J3.2, U1.3 (RA4)
unnamed: J3.3, R4.7 (R6)
unnamed: J3.4, U1.4 (RA5)
unnamed: J3.5, R4.8 (R7)
unnamed: J3.6, U1.18 (RB0)
unnamed: J3.7, R4.9 (R8)
unnamed: J3.8, U1.19 (RB1)
unnamed: J4.1, R3.2 (R1)
unnamed: J4.2, U1.20 (RB2)
unnamed: J4.3, R3.3 (R2)
unnamed: J4.4, U1.21 (RB3)
unnamed: J4.5, R3.4 (R3)
unnamed: J4.6, U1.22 (RB4)
unnamed: J4.7, R3.5 (R4)
unnamed: J4.8, U1.23 (RB5)
unnamed: J5.1, R3.6 (R5)
unnamed: J5.2, U1.8 (RC0)
unnamed: J5.3, R3.7 (R6)
unnamed: J5.4, U1.9 (RC1)
unnamed: J5.5, R3.8 (R7)
unnamed: J5.6, U1.10 (RC2)
unnamed: J5.7, U1.13 (RC5)
unnamed: J5.8, R3.9 (R8)
unnamed: J6.1, J7.5, J8.5, R6.2, U1.11 (RC3)
unnamed: J6.2, J7.4, J8.4, R7.2, U1.12 (RC4)
unnamed: TP1.1, U1.7 (RA6)
unnamed: U1.5 (V_{SS}), U1.16 (V_{SS})
