ju8t1n203/Midi-Bass-Guitar/PluckSlave/PluckMuteSlave/PluckMuteSlave.kicad_sch

## KiCad design PluckSlave/PluckMuteSlave/PluckMuteSlave.kicad_sch (2025-11-13)

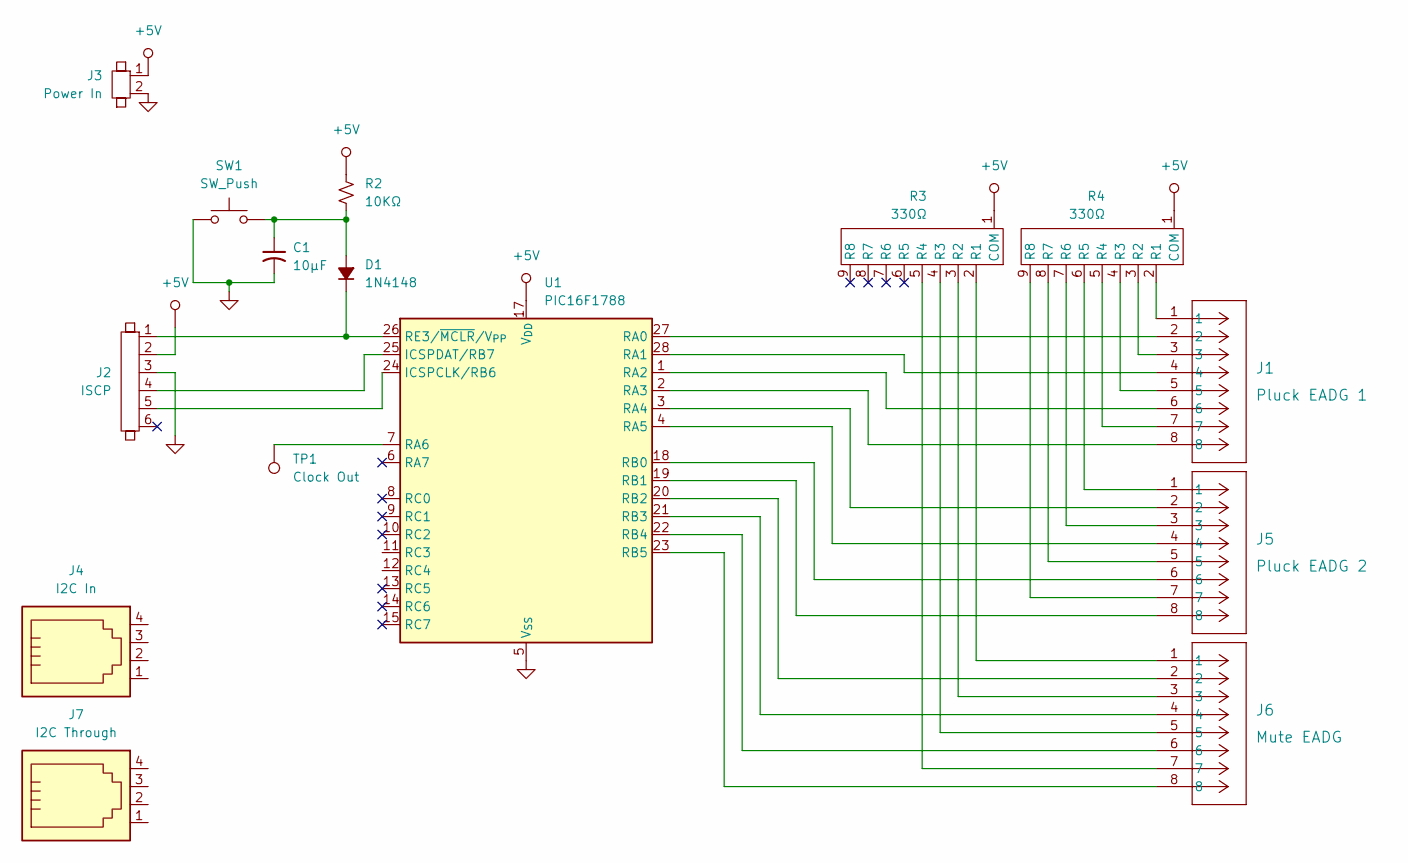
[picture p138: schematic PluckMuteSlave.kicad_sch]

Parts:
C1: 10µF
D1: 1N4148
J1: Pluck EADG 1; CONN_SD-43045-004_08_MOL
J2: ISCP
J3: Power In; 1X2_100mil_Header
J4: I2C In
J5: Pluck EADG 2; CONN_SD-43045-004_08_MOL
J6: Mute EADG; CONN_SD-43045-004_08_MOL
J7: I2C Through
R2: 10KΩ
R3, R4: 330Ω
SW1: SW_Push
TP1: Clock Out
U1: PIC16F1788; QFN-28-1EP_6x6mm_P0.65mm_EP4.25x4.25mm

Connections:
+5V: J2.2, J3.1, R2.1, R3.1 (COM), R4.1 (COM), U1.17 (V_{DD})
GND: C1.2, J2.3, J3.2, SW1.1, U1.5 (V_{SS}), U1.16 (V_{SS})
unnamed: C1.1, D1.2 (A), R2.2, SW1.2
unnamed: D1.1 (K), J2.1, U1.26 (RE3/~MCLR/V_{PP})
unnamed: J1.1, R4.2 (R1)
unnamed: J1.2, U1.27 (RA0)
unnamed: J1.3, R4.3 (R2)
unnamed: J1.4, U1.28 (RA1)
unnamed: J1.5, R4.4 (R3)
unnamed: J1.6, U1.1 (RA2)
unnamed: J1.7, R4.5 (R4)
unnamed: J1.8, U1.2 (RA3)
unnamed: J2.4, U1.25 (ICSPDAT/RB7)
unnamed: J2.5, U1.24 (ICSPCLK/RB6)
unnamed: J5.1, R4.6 (R5)
unnamed: J5.2, U1.3 (RA4)
unnamed: J5.3, R4.7 (R6)
unnamed: J5.4, U1.4 (RA5)
unnamed: J5.5, R4.8 (R7)
unnamed: J5.6, U1.18 (RB0)
unnamed: J5.7, R4.9 (R8)
unnamed: J5.8, U1.19 (RB1)
unnamed: J6.1, R3.2 (R1)
unnamed: J6.2, U1.20 (RB2)
unnamed: J6.3, R3.3 (R2)
unnamed: J6.4, U1.21 (RB3)
unnamed: J6.5, R3.4 (R3)
unnamed: J6.6, U1.22 (RB4)
unnamed: J6.7, R3.5 (R4)
unnamed: J6.8, U1.23 (RB5)
unnamed: TP1.1, U1.7 (RA6)
