ju8t1n203/Midi-Bass-Guitar/IR_MIDI/Midi_IR_Rx/Rx/Rx.kicad_sch

## KiCad design IR_MIDI/Midi_IR_Rx/Rx/Rx.kicad_sch (2025-11-05)

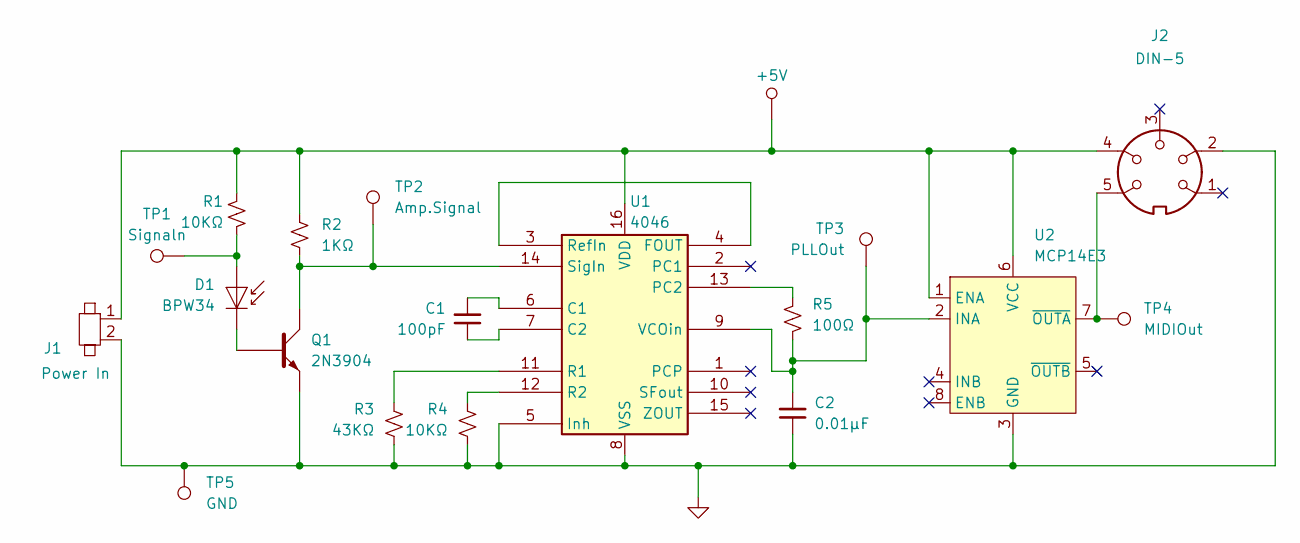
[picture p139: schematic Rx.kicad_sch]

Parts:
C1: 100pF; C_0805
C2: 0.01µF; C_0805
D1: BPW34; Osram_DIL2_4.3x4.65mm_P5.08mm
J1: Power In; RCA Jack P177
J2: DIN-5; DIN-5PIN_MIDI
Q1: 2N3904; TO-92_Inline
R1, R4: 10KΩ; C_0805
R2: 1KΩ; C_0805
R3: 43KΩ; C_0805
R5: 100Ω; C_0805
TP1: Signaln
TP2: Amp.Signal
TP3: PLLOut
TP4: MIDIOut
TP5: GND
U1: 4046; SOP-16_4.4x10.4mm_P1.27mm
U2: MCP14E3

Connections:
+5V: J1.1, J2.4, R1.2, R2.2, U1.16 (VDD), U2.1 (ENA), U2.6 (VCC)
GND: C2.1, J1.2, J2.2, Q1.1 (E), R3.2, R4.2, TP5.1, U1.5 (Inh), U1.8 (VSS), U2.3 (GND)
unnamed: C1.1, U1.7 (C2)
unnamed: C1.2, U1.6 (C1)
unnamed: C2.2, R5.2, TP3.1, U1.9 (VCOin), U2.2 (INA)
unnamed: D1.1 (K), Q1.2 (B)
unnamed: D1.2 (A), R1.1, TP1.1
unnamed: J2.5, TP4.1, U2.7 (~OUTA)
unnamed: Q1.3 (C), R2.1, TP2.1, U1.14 (SigIn)
unnamed: R3.1, U1.11 (R1)
unnamed: R4.1, U1.12 (R2)
unnamed: R5.1, U1.13 (PC2)
unnamed: U1.3 (RefIn), U1.4 (FOUT)
