ju8t1n203/Midi-Bass-Guitar/(commit log)

2025-11-05 updated file structures and refreshed MIDI circuits
    [10th Fret Bar.SLDPRT, 10th Fret Bar.STL, 11th Fret Bar.SLDPRT, 11th Fret Bar.STL, 12th Fret Bar.SLDPRT, 12th Fret Bar.STL, 14th Fret Bar.SLDPRT, 14th Fret Bar.STL]
2025-11-05 started modeling new fret system
    [10th Fret Bar.STL, 11th Fret Bar.STL, 12th Fret Bar.STL, 14th Fret Bar.STL, 16th Fret Bar.STL, 18th Fret Bar.STL, 20th Fret Bar.STL, 2nd Fret Bar.STL]
2025-11-11 some cad work and updated midi note charts
    [GenrealBar.0005.ipt, GenrealBar.ipt, GenrealBar.stl, JustinHours.xlsx, Midi Notes and Real Notes.ods, SolenoidMount.0002.ipt, SolenoidMount.0003.ipt, SolenoidMount.ipt]
2025-11-12 added i2c protocol
    [GenrealBar.0005.ipt, GenrealBar.0006.ipt, GenrealBar.ipt, GenrealBar.stl, JustinHours.xlsx]
2025-11-13 updated Universal Master schematic
    [JustinHours.xlsx, UMaster.kicad_sch]
2025-11-13 made new master, pluck and fret circuits
    [FretSlaveV2.kicad_pcb, FretSlaveV2.kicad_sch, JustinHours.xlsx, PluckMuteSlave.kicad_pcb, PluckMuteSlave.kicad_sch, UMaster.kicad_sch]
2025-11-14 decided on utilizing a universal setup for the slave board
    [FretSlaveV2.kicad_sch, USlave.kicad_pcb, USlave.kicad_sch]
2025-11-15 designed universal PCB
    [JustinHours.xlsx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]
2025-11-16 revised IR Tx board
    [Tx-B_Cu.gbr, Tx-B_Mask.gbr, Tx-B_Silkscreen.gbr, Tx-Edge_Cuts.gbr, Tx-F_Cu.gbr, Tx-F_Mask.gbr, Tx-F_Silkscreen.gbr, Tx-NPTH.drl]
2025-11-16 made solenoid relay circuit and board
    [UniversalSolenoidRelay-B_Cu.gbr, UniversalSolenoidRelay-B_Mask.gbr, UniversalSolenoidRelay-B_Silkscreen.gbr, UniversalSolenoidRelay-Edge_Cuts.gbr, UniversalSolenoidRelay-F_Cu.gbr, UniversalSolenoidRelay-F_Mask.gbr, UniversalSolenoidRelay-F_Silkscreen.gbr, UniversalSolenoidRelay-NPTH.drl]
